AugustoRiedinger/tecDig2_project/doc/proyectoCompleto_Riedinger-Garcia/informe/informe.pdf

# Sistema de adquisión y transmisión de datos autosuficiente y controlable

A. Riedinger
Universidad Tecnológica Nacional Departamento de Electrónica Cátedra de Técnicas Digitales II Bahía Blanca, Argentina
Email: ariedinger4@duck.com
G. Garcia
Universidad Tecnológica Nacional Departamento de Electrónica Cátedra de Técnicas Digitales II Bahía Blanca, Argentina
Email: gerogarcia00@hotmail.com

ÍNDICE

I. | Descripcion general: | 1
II. | Hardware: | 3
II-C. | Descripción del circuito ERDYTC: . . . | 3
II-D. | Descripción del circuito SATDAT: . . . | 3
III. | Software: | 4
I. DESCRIPCION GENERAL:

I-A. Introduccion:
El objetivo del proyecto es construir un sistema digital de sensado autosuficiente, con la premisa de ser controlado a través de una estación de recepción de datos.
Esto es, el proyecto se divide en dos sistemas que trabajan de forma codependiente pero que son controlados por microcontroladores distintos:
Uno es el SATDAC (Sistema de Adquisicón y Transmisión de Datos Autosuficiente y Controlable), encargado de tomar y procesar muestras u obtener datos.
Otro es la ERDYTC (Estación de Recepción de Datos Y Transmisión de Comandos), que se encontraría conectada al SATDAC y se encargaría de mostrar los datos obtenidos.
El SATDAC posee las siguientes capacidades:
Sensado de variables analógicas; actualmente solo temperatura con presición de 2 decimales en un rango de 22.0 °C a 32 °C.
Control y despliegue de periféricos por comando.

Almacenamiento en memoria externa.
Recepción y transmisión de datos por puerto USART. Físicamente, el SATDAC cuenta con una compuerta que está inicialmente cerrada pero puede ser abierta remotamente solo a través de la ERDYTC.
Y la ERDYTC las siguientes:
Capacidad para mostrar datos recibidos y estados en LCD.
Ingreso de comandos por usuario y transmisión de los mismos.
Recepción y transmisión de datos por puerto USART.

I-B. Interfaz con el usuario:
El sistema que más interacciona con el usuario es la ERDYTC. La misma cuenta con las siguientes cualidades: Encendido: el sistema se prende inmediatamente al conetarlo a la red (220 [Vac] @ 50[Hz]).
Pulsadores: el sistema cuenta con cinco (5) pulsadores para que el usuario interaccione con el SATDAC. Estos pulsadores estan denotados en la carcasa del sistema:
- Pulsador 1 - Temperatura: envía un comando al SATDAC para que transmita el valor instantáneo de temperatura tomado. Este valor se visualizará inmediatamente en el display LCD con el que cuenta la ERDYTC.
- Pulsador 2 - Servo posición 1: envía un comando al SATDAC para movilizar el servo a la posición en que destrabará la compuerta de acceso.
- Pulsador 3 - Servo posicipon 2: envía un comando al SATDAC para cerrar a través del mismo servomotor la compuerta de acceso.
- Pulsador 4 - Guardar datos en SD: envía un comando al SATDAC para indicar que guarde el último valor de temperatura leído en la memoria externa SD.
- Pulsador 5 - Reset: pulsador para resetear físicamente la ERDYTC.
Display LCD: el sistema cuenta con un LCD 2x16 donde se muestran los estados y transiciones de la ERDYTC, como también las acciones que realiza en el momento el SATDAC.

Luego, el SATDAC es, como se dijo en la introducción, un sistema cerrado que solo posee una capacidad de interacción con el usuario: la memoria SD donde se almacena el último dato de temperatura medido. Luego, el control del SATDAC se da a través de la ERDYTC.

I-C. Operación:
El sistema está pensado para ser controlado completamente a partir de la ERDYTC. El principio de operación que se debería serguir es el siguiente:
A través de la ERDYTC, presionar el pulsador 1 para indicarle al SATDAC que tome una muestra de temperatura.
Una vez vista la temperatura en el LCD local de la ERDYTC, presionar el pulsador 4 para almacenar dicho valor de temperatura en la SD.
Repetir dicho proceso todas las veces que sea necesario. Una vez finalizado, presionar el pulsador 2 para abrir la ocmpuerta del SATDAC.
Una vez que se indica que la compuerta fue abierta, es posible acceder al SATDAC y realizar la extracción de la memoria SD.
Luego, presionar pulsador 3 para sellar la compuerta; y repetir estos dos últimos pasos una vez que la memoria SD fue utilizada (se extrajeron los datos de la memoria).

I-D. Menúes:
Se describirán los distintos menúes que se visualizan en la ERDYTC.
Pantalla inicial: menú que se muestra al iniciar el sistema. Indica el último valor de temperatura medido por el SATDAC. Se puede visualizar en la Fig. 1.

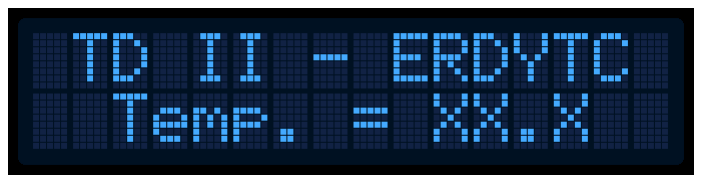
[picture p9: figure]

Figura 1: Menú pantalla inicial

Pantalla actualización temperatura: mensaje que se muestra al presionar el Pulsador 1 - Temperatura. Indica que el SATDAC se encuentra en proceso de actualizar el valor de temperatura. Se puede visualizar en la Fig. 2.

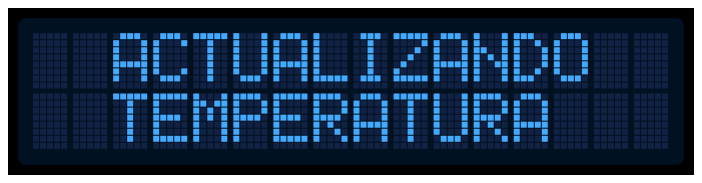
[picture p10: figure]

Figura 2: Pantalla actualización temperatura

. Pantalla servo posición 1: mensaje que se muestra al presionar el Pulsador 2 - Servo posición 1. Indica que el servomotor del SATDAC se movió 90° con respecto a su posición inicial y por tanto se destrabó la compuerta para acceder al mismo. Se puede visualizar en la Fig. 3

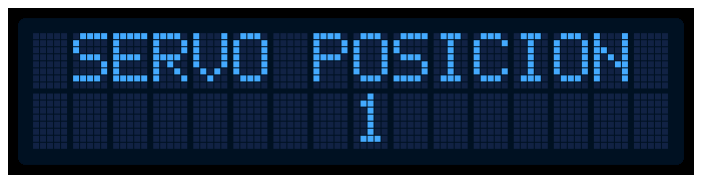
[picture p11: figure]

Figura 3: Pantalla servo posición 1

Pantalla servo posición 2: mensaje que se muestra al presionar el Pulsador 3 - Servo posición 2. Indica que el servomotor del SATDAC se movió 90° con respecto a su posición final y por tanto se trabó la compuerta para acceder al mismo. Se puede visualizar en la Fig. 4.

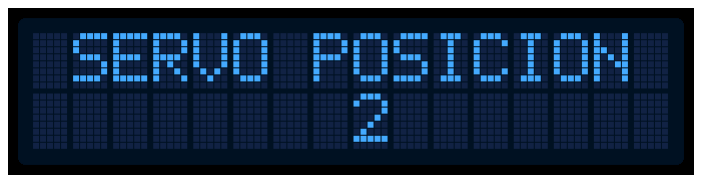
[picture p12: figure]

Figura 4: Pantalla servo posición 2

Pantalla SD: mensaje que se muestra al presionar el Pulsador 4 - SD. Indica que el SATDAC se encuentra en el proceso de guardar el último valor de temperatura en la memoria externa SD. Se puede visualizar en la Fig. 5.

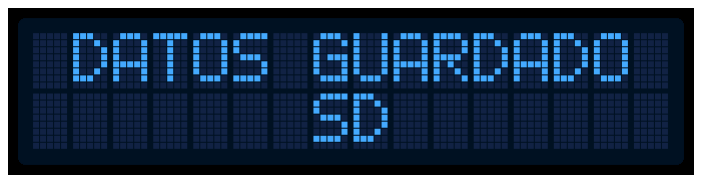
[picture p13: figure]

Figura 5: Pantalla SD

Todos los menúes anteriormente descritos se pueden visualizar durante 5 segundos luego de que aparecen (a exepción de la pantalla inicial, que es el mensaje que se muestra por defecto) para que el usuario tenga tiempo necesario a leer o anotar lo que se ve.

I-E. Mantenimiento:

Para realizar el mantenimiento de la ERDYTC no se debe realizar ninguna operación especial, basta con desarmar la carcasa de la misma y retirar el microcontrolador de la placa PCB que se encuentra en su interior.
En cambio, para realizar el mantenimiento del SATDAC es necesario tener la ERDYTC en funcionamiento. A partir de ello, se debe realizar el siguiente procedimiento:
Presionar el pulsador 2 en la ERDYTC para abrir la compuerta del SATDAC.
Desconectar la ERDYTC de la red de alimentación. Desconetar la batería del SATDAC.

Una vez finalizado el mantenimiento del SATDAC, se debe trabar manualmente la compuerta a partir de colocar el servomotor en su lugar inicial.
I-E1. Seguridad:: Se debe desconectar de la red y/o alimentación todos los elementos antes de realizar el mantenimiento.
Idealmente, también sería inteligente deshacer la conexión entre el SATDAC y la ERDYTC antes de realizar el mantenimiento de un sistema de forma independientemente.

II. HARDWARE:

II-A. Estructuras:
Ambos sistemas se encuentran en estructuras protectoras o carcasas hechas en madera. Las mismas se pueden visualizar en las Fig. 6 y 7 respectivamente.


Figura 6: Carcasa del SATDAC


Figura 7: Carcasa de la ERDYTC

II-B. Diagrama en bloques:
En la Fig. 8 se puede visualizar el diagrama en bloques completo de ambos sistemas interconectados.

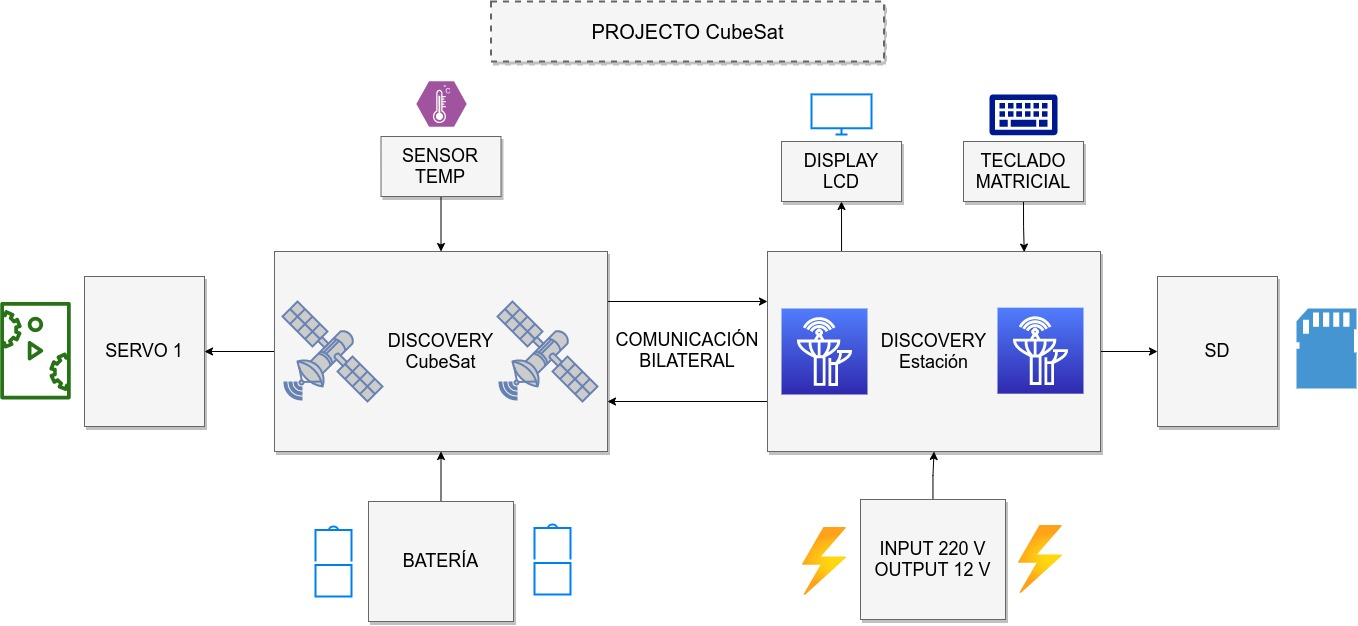
[picture p14: figure]

Figura 8: Diagrama en bloques de los sistemas

En el mismo se puede observar de forma gráfica las distintas conexiones y funciones de los sistemas descritos en este documento. Se observa que el SATDAC posee como alimentación una batería de 3.7 [V], y la ERDYTC se alimenta a partir de la RED. Además, se denotan los diferentes periféricos utilizados en ambos sistemas.

II-C. Descripción del circuito ERDYTC:
En la Fig. 9 se puede observar el circuito esquemático que representa la ERDYTC.


Figura 9: Circuito esquemático de la ERDYTC

En el mismo se describe el conexionado del sistema:
Se utilizaron los conectores CN8 y CN9 de la STM32F429ZI para realizar todas las conexiones a través de un poncho.
La conexión del display LCD se realizó con resistencias de pull-up a 5 voltios, y las conexiones a los pines de la STM se dan todas en el conector CN9.
La conexión de los pulsadores se da en forma matricial. Luego, en la Fig. 10 se puede observar el circuito impreso o PCB de la ERDYTC. En el mismo se nota claramente que se utilizó el conector de Arduino de la STM para realizar el poncho con la placa.
Finalmente, en la Fig. 11 se puede observar el PCB físico de la ERDYTC.

II-D. Descripción del circuito SATDAT:
En la Fig. 12 se puede observar el diagrama esquemático del SATDAC.
En el mismo se puede ver el conexionado del sistema: Se utilizaron los conectores CN8 y CN9 de la STM para realizar el poncho.


Figura 10: ERTDYC PCB

Se utilizó un circuito amplificador de protección para el conexionado del sensor de temperatura LM35.

Los puertos UART usados tanto en el SATDA como ERDYTC fueron el PA2 y PA3 respectivamente, y se corresponden con el UART2 en el sistema.
Luego en la Fig. 13 se puede observar el PCB del SATDAC, y en la Fig. 14 el modelo 3D del mismo.

III. SOFTWARE:

III-A. Código fuente:

La descripción completa de todo el software se puede visualizar en el siguiente enlace: https://github.com/AugustoRiedinger/tecDig2_project/tree/master/code. (https://github.com/AugustoRiedinger/tecDig2_project/tree/master/code)
En el mismo, también se pueden descargar y contribuir a todos los archivos tanto del software como del proyecto en general.
En la carpeta code se puede encontrar y editar el código fuente que se carga en ambos sistemas. Notar que el archivo hardware.h describe los pines utilizados para los dos sistemas; el mismo se puede editar fácilmente y a conveniencia que cambiará todas las funciones donde sea utilizado.

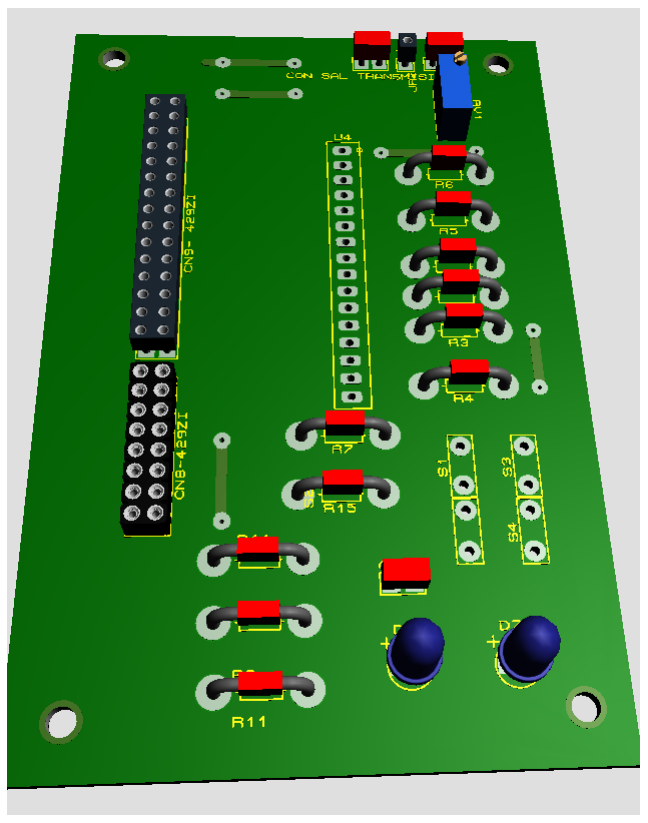
[picture p15: figure]

Figura 11: Render 3D del PCD de la ERDYTC


Figura 12: Esquemático del SATDAC

III-B. Lenguaje:

El lenguaje utilizo en todas las librerías creadas y el código fuente es C, junto con funciones específicas desarrolladas por ST.
C es un lenguaje de programación de propósito general originalmente desarrollado por Dennis Ritchie entre 1969 y 1972 en los Laboratorios Bell, como evolución del anterior lenguaje B, a su vez basado en BCPL.
Al igual que B, es un lenguaje orientado a la implementación de sistemas operativos, concretamente Unix. C es apreciado por la eficiencia del código que produce y es el lenguaje de programación más popular para crear softwares

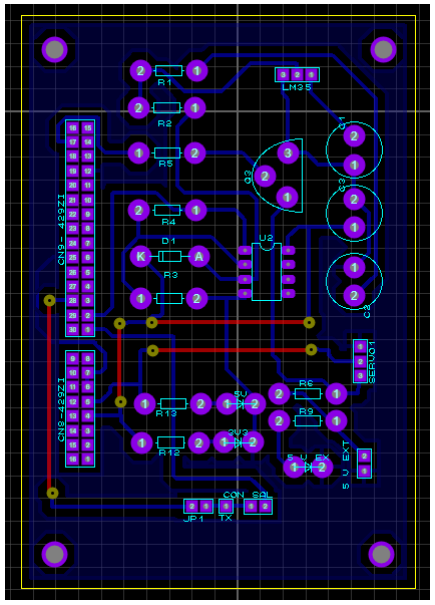
[picture p16: figure]

Figura 13: SATDAC PCB

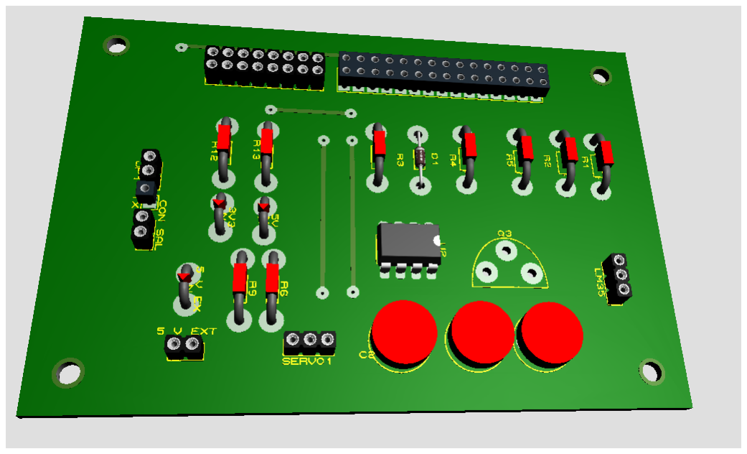
[picture p17: figure]

Figura 14: SATDAC 3D

de sistemas y aplicaciones.
Se trata de un lenguaje de tipos de datos estáticos, débilmente tipado, de medio nivel, que dispone de las estructuras típicas de los lenguajes de alto nivel pero, a su vez, dispone de construcciones del lenguaje que permiten un control a bajo nivel. Los compiladores suelen ofrecer extensiones al lenguaje que posibilitan mezclar código en ensamblador con código C o acceder directamente a memoria o dispositivos periféricos.

III-C. Entorno de desarrollo:

Para editar los archivos principalmente se utilizó el software Doom Emacs; luego para debuggear se utilizó Atollic

TRUEStudio.
Los programas utilizados tanto para editar como para debuggear son a elección, pero los autores solamente testearon en los mencionados.
