AugustoRiedinger/tecDig2_project/doc/proyectoCompleto_Riedinger-Garcia/satdac/PCB SD.png

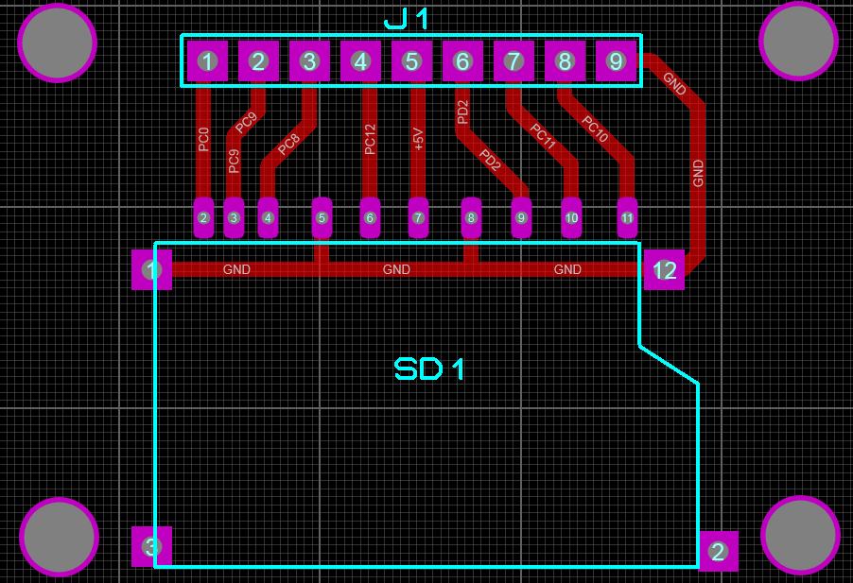
doc/proyectoCompleto_Riedinger-Garcia/satdac/PCB SD.png
