AugustoRiedinger/tecDig2_project/images/estacionEsquematico.BMP

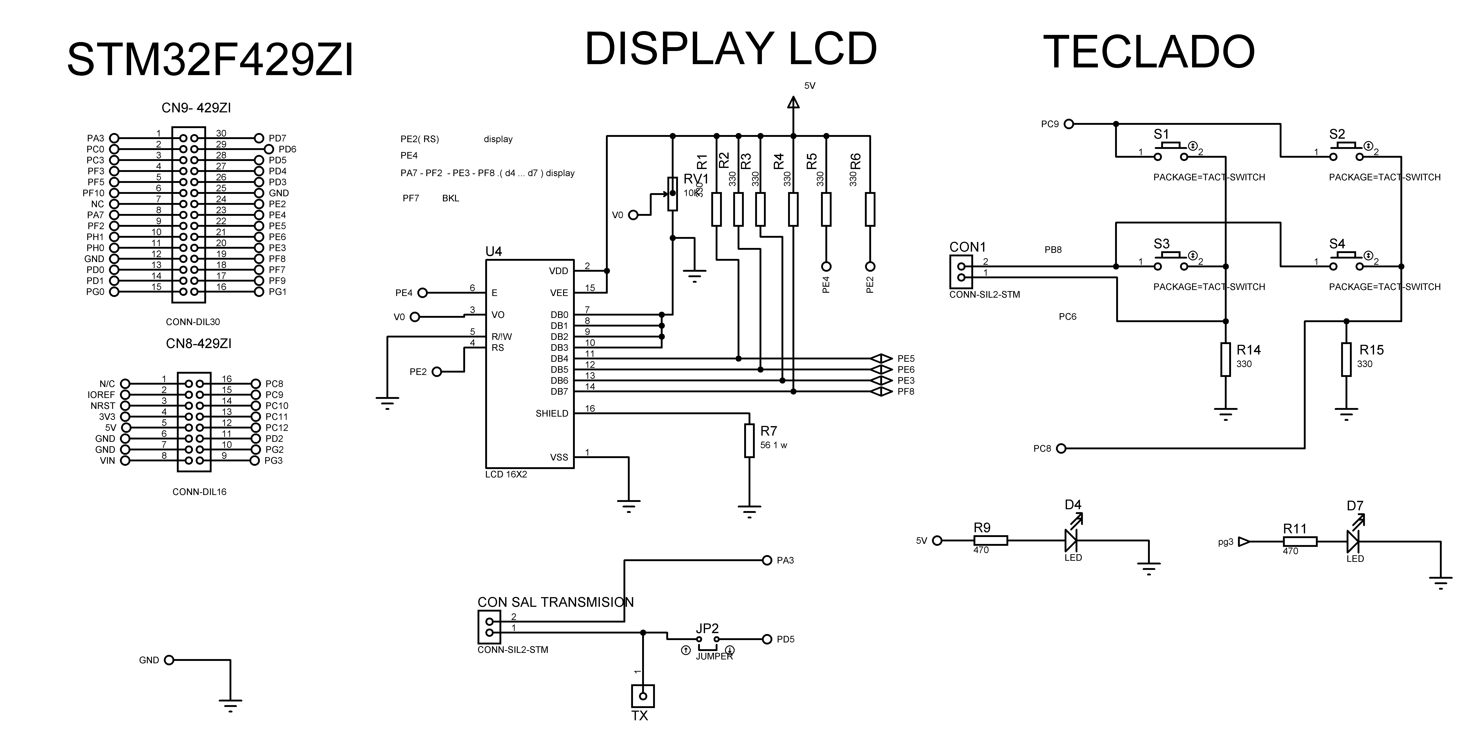
images/estacionEsquematico.BMP
