AugustoRiedinger/tecDig2_project/images/servo_1ms.BMP

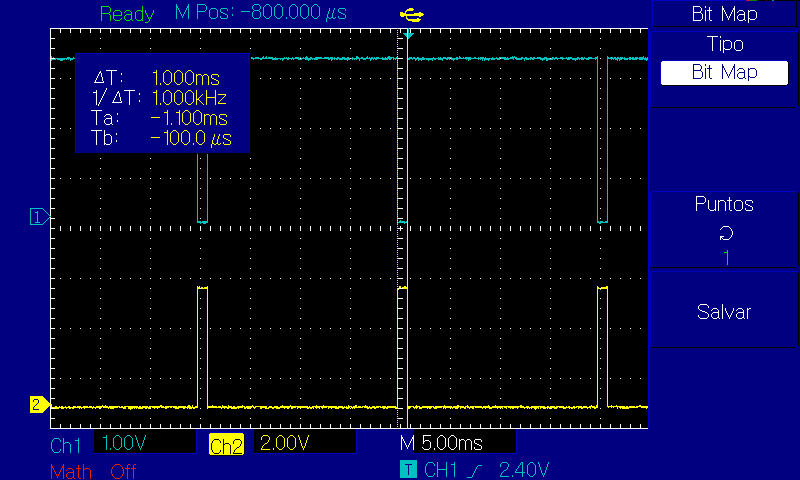
images/servo_1ms.BMP
