AugustoRiedinger/tecDig2_project/(list of files, drawings)

Other design files:
doc/proyectoCompleto_Riedinger-Garcia/proteus/cube V1.4( final).pdsprj
doc/proyectoCompleto_Riedinger-Garcia/proteus/estacion v1.3.pdsprj
