AugustoRiedinger/tecDig2_project/doc/proyectoCompleto_Riedinger-Garcia/satdac/SD-Card 2021-407/src/stm32_ub_sdcard.c

//--------------------------------------------------------------
// File     : stm32_ub_sdcard.c
// Datum    : 01.05.2014
// Version  : 1.2
// Autor    : UB
// EMail    : mc-4u(@)t-online.de
// Web      : www.mikrocontroller-4u.de
// CPU      : STM32F4
// IDE      : CooCox CoIDE 1.7.4
// GCC      : 4.7 2012q4
// Module   : GPIO, MISC, SDIO, DMA
// Funktion : FATFS-Dateisystem für SD-Medien
//            LoLevel-IO-Modul
//            Quelle = STM-Files
//            stm324xg_eval_sdio_sd.c [V1.1.1/11-January-2013]
//            stm324xg_eval.c [V1.1.1/11-January-2013]
// Hinweis  : Betrieb per DMA und SDIO-Schnittstelle
//
// 1bit-Mode :
//
//   PC8  -> SDIO_D0  = SD-Karte DAT0
//   PC12 -> SDIO_CK  = SD-Karte Clock
//   PD2  -> SDIO_CMD = SD-Karte CMD
//
// 4bit-Mode :
//
//   PC8  -> SDIO_D0  = SD-Karte DAT0  (pin 8 tarjeta)
//   PC9  -> SDIO_D1  = SD-Karte DAT1  (pin 9 tarjeta)
//   PC10 -> SDIO_D2  = SD-Karte DAT2  (pin 1 tarjeta)
//   PC11 -> SDIO_D3  = SD-Karte DAT3/CD  (pin 2 tarjeta)
//   PC12 -> SDIO_CK  = SD-Karte Clock  (pin 6 tarjeta)
//   PD2  -> SDIO_CMD = SD-Karte CMD    (pin 3 tarjeta)
//										VDD pin 5
//										GND pin 4 y 7
// mit Detect-Pin :
//
//   PC0  -> SD_Detect-Pin (Hi=ohne SD-Karte)
//            
//              DMA : entweder DMA2_STREAM3_CHANNEL4
//                    oder     DMA2_STREAM6_CHANNEL4
//--------------------------------------------------------------
// Warning  : The STM32F4 in Revision-A generates a
//            "SDIO_IT_DCRCFAIL" in function "SD_ProcessIRQSrc"
//            To avoid this set the Define "SDIO_STM32F4_REV" to 0
//            (check the STM-Errata-Sheet for more information)
//            [Thanks to Major for posting this BUG...UB]
//--------------------------------------------------------------




//--------------------------------------------------------------
// Includes
//--------------------------------------------------------------
#include "stm32_ub_sdcard.h"


//--------------------------------------------------------------
// Globale Variabeln
//--------------------------------------------------------------
static uint32_t CardType =  SDIO_STD_CAPACITY_SD_CARD_V1_1;
static uint32_t CSD_Tab[4], CID_Tab[4], RCA = 0;
static uint8_t SDSTATUS_Tab[16];
__IO uint32_t StopCondition = 0;
__IO SD_Error TransferError = SD_OK;
__IO uint32_t TransferEnd = 0, DMAEndOfTransfer = 0;
SD_CardInfo SDCardInfo;

SDIO_InitTypeDef SDIO_InitStructure;
SDIO_CmdInitTypeDef SDIO_CmdInitStructure;
SDIO_DataInitTypeDef SDIO_DataInitStructure;


//--------------------------------------------------------------
// interne Funktionen
//--------------------------------------------------------------
static void NVIC_Configuration(void);
void SD_DeInit(void);
SD_Error SD_Init(void);
SDTransferState SD_GetStatus(void);
SDCardState SD_GetState(void);
uint8_t SD_Detect(void);
SD_Error SD_PowerON(void);
SD_Error SD_PowerOFF(void);
SD_Error SD_InitializeCards(void);
SD_Error SD_GetCardInfo(SD_CardInfo *cardinfo);
SD_Error SD_GetCardStatus(SD_CardStatus *cardstatus);
SD_Error SD_EnableWideBusOperation(uint32_t WideMode);
SD_Error SD_SelectDeselect(uint64_t addr);
SD_Error SD_ReadBlock(uint8_t *readbuff, uint64_t ReadAddr, uint16_t BlockSize);
SD_Error SD_ReadMultiBlocks(uint8_t *readbuff, uint64_t ReadAddr, uint16_t BlockSize, uint32_t NumberOfBlocks);
SD_Error SD_WaitReadOperation(void);
SD_Error SD_WriteBlock(uint8_t *writebuff, uint64_t WriteAddr, uint16_t BlockSize);
SD_Error SD_WriteMultiBlocks(uint8_t *writebuff, uint64_t WriteAddr, uint16_t BlockSize, uint32_t NumberOfBlocks);
SD_Error SD_WaitWriteOperation(void);
SDTransferState SD_GetTransferState(void);
SD_Error SD_StopTransfer(void);
SD_Error SD_Erase(uint64_t startaddr, uint64_t endaddr);
SD_Error SD_SendStatus(uint32_t *pcardstatus);
SD_Error SD_SendSDStatus(uint32_t *psdstatus);
SD_Error SD_ProcessIRQSrc(void);
void SD_ProcessDMAIRQ(void);
static SD_Error CmdError(void);
static SD_Error CmdResp7Error(void);
static SD_Error CmdResp1Error(uint8_t cmd);
static SD_Error CmdResp3Error(void);
static SD_Error CmdResp2Error(void);
static SD_Error CmdResp6Error(uint8_t cmd, uint16_t *prca);
static SD_Error SDEnWideBus(FunctionalState NewState);
static SD_Error IsCardProgramming(uint8_t *pstatus);
static SD_Error FindSCR(uint16_t rca, uint32_t *pscr);
uint8_t convert_from_bytes_to_power_of_two(uint16_t NumberOfBytes);
SD_Error SD_HighSpeed (void);
//--------------------------------------------------------------
void SD_LowLevel_DeInit(void);
void SD_LowLevel_Init(void);
void SD_LowLevel_DMA_TxConfig(uint32_t *BufferSRC, uint32_t BufferSize);
void SD_LowLevel_DMA_RxConfig(uint32_t *BufferDST, uint32_t BufferSize);
//--------------------------------------------------------------




//--------------------------------------------------------------
// init der Hardware fuer die SDCard-Funktionen
// muss vor der Benutzung einmal gemacht werden
//--------------------------------------------------------------
void UB_SDCard_Init(void)
{
  // Interrupt-Controller initialisieren
  NVIC_Configuration();
  // GPIO initialisieren
  SD_LowLevel_Init();
}


//--------------------------------------------------------------
// Check ob Medium eingelegt ist
// Return Wert :
//   SD_PRESENT      = wenn Medium eingelegt ist
//   SD_NOT_PRESENT  = wenn kein Medium eingelegt ist
//--------------------------------------------------------------
uint8_t UB_SDCard_CheckMedia(void)
{
  __IO uint8_t status = SD_NOT_PRESENT;

  // Abfrage ob SD-Karte eingesteckt
  status=SD_Detect();

  return(status);
}


//--------------------------------------------------------------
// init der Disk
// Return Wert :
//    0 = alles ok
//  < 0 = Fehler
//--------------------------------------------------------------
int MMC_disk_initialize(void)
{
  int ret_wert=-1;
  SD_Error res = SD_OK;
  
  res=SD_Init();
  
  if(res == SD_OK) {
    ret_wert=0; // Ok
  }
  else {
    ret_wert=-1;
  }

  return(ret_wert);
}


//--------------------------------------------------------------
// Disk Status abfragen
// Return Wert :
//    0 = alles ok
//  < 0 = Fehler
//--------------------------------------------------------------
int MMC_disk_status(void)
{
  int ret_wert=-1;
  uint8_t state;

  state=SD_Detect();
  if(state==SD_PRESENT) {
    ret_wert=0;
  }
  else {
    ret_wert=-1;
  }

  return(ret_wert);
}


//--------------------------------------------------------------
// READ-Funktion
// Return Wert :
//    0 = alles ok
//  < 0 = Fehler
//--------------------------------------------------------------
int MMC_disk_read(BYTE *buff, DWORD sector, BYTE count)
{
  int ret_wert=-1;
  SD_Error status = SD_OK;

  SD_ReadMultiBlocks(buff, sector << 9, 512, 1);

  /* Check if the Transfer is finished */
  status =  SD_WaitReadOperation();
  while(SD_GetStatus() != SD_TRANSFER_OK);

  if (status == SD_OK) {
    ret_wert=0;
  }
  else {
    ret_wert=-1;
  }


  return(ret_wert);
}


//--------------------------------------------------------------
// WRITE-Funktion
// Return Wert :
//    0 = alles ok
//  < 0 = Fehler
//--------------------------------------------------------------
int MMC_disk_write(const BYTE *buff, DWORD sector, BYTE count)
{
  int ret_wert=-1;

  SD_Error status = SD_OK;

  SD_WriteMultiBlocks((BYTE *)buff, sector << 9, 512, 1);

  /* Check if the Transfer is finished */
  status = SD_WaitWriteOperation();
  while(SD_GetStatus() != SD_TRANSFER_OK);     

  if (status == SD_OK) {
    ret_wert=0;
  }
  else {
    ret_wert=-1;
  }

  return(ret_wert);
}


//--------------------------------------------------------------
// IOCTL-Funktion
// Return Wert :
//    0 = alles ok
//  < 0 = Fehler
//--------------------------------------------------------------
int MMC_disk_ioctl(BYTE cmd, void *buff)
{
  int ret_wert=0; // immer ok

  switch (cmd) {
    case GET_SECTOR_COUNT :    // Get number of sectors on the disk (DWORD)
      *(DWORD*)buff = 131072;  // 4*1024*32 = 131072
      ret_wert = 0;
    break;
    case GET_SECTOR_SIZE :     // Get R/W sector size (WORD) 
      *(WORD*)buff = 512;
      ret_wert = 0;
    break;
    case GET_BLOCK_SIZE :      // Get erase block size in unit of sector (DWORD)
      *(DWORD*)buff = 32;
      ret_wert = 0;
    break;
    case CTRL_SYNC :
      ret_wert = 0;
    break;
    case CTRL_ERASE_SECTOR :
      ret_wert = 0;
    break;
  }

  return(ret_wert);
}




//--------------------------------------------------------------
static void NVIC_Configuration(void)
{
  NVIC_InitTypeDef NVIC_InitStructure;

  NVIC_PriorityGroupConfig(NVIC_PriorityGroup_1);

  NVIC_InitStructure.NVIC_IRQChannel = SDIO_IRQn;
  NVIC_InitStructure.NVIC_IRQChannelPreemptionPriority = 0;
  NVIC_InitStructure.NVIC_IRQChannelSubPriority = 0;
  NVIC_InitStructure.NVIC_IRQChannelCmd = ENABLE;
  NVIC_Init(&NVIC_InitStructure);
  NVIC_InitStructure.NVIC_IRQChannel = SD_SDIO_DMA_IRQn;
  NVIC_InitStructure.NVIC_IRQChannelPreemptionPriority = 1;
  NVIC_Init(&NVIC_InitStructure);
}



//--------------------------------------------------------------
// Funktionen vom File :
// stm324xg_eval_sdio_sd.c
// V1.1.1
// 11-January-2013
//--------------------------------------------------------------


//--------------------------------------------------------------
void SD_DeInit(void)
{ 
  SD_LowLevel_DeInit();
}

//--------------------------------------------------------------
// Init der SD-Karte
// -> die restliche Initialisierung (GPIO,NVIC)
//    muss schon gemacht sein
//--------------------------------------------------------------
SD_Error SD_Init(void)
{
  __IO SD_Error errorstatus = SD_OK;
  
  
  SDIO_DeInit();

  errorstatus = SD_PowerON();

  if (errorstatus != SD_OK)
  {
    /*!< CMD Response TimeOut (wait for CMDSENT flag) */
    return(errorstatus);
  }

  errorstatus = SD_InitializeCards();

  if (errorstatus != SD_OK)
  {
    /*!< CMD Response TimeOut (wait for CMDSENT flag) */
    return(errorstatus);
  }

  /*!< Configure the SDIO peripheral */
  /*!< SDIO_CK = SDIOCLK / (SDIO_TRANSFER_CLK_DIV + 2) */
  /*!< on STM32F4xx devices, SDIOCLK is fixed to 48MHz */
  SDIO_InitStructure.SDIO_ClockDiv = SDIO_TRANSFER_CLK_DIV;
  SDIO_InitStructure.SDIO_ClockEdge = SDIO_ClockEdge_Rising;
  SDIO_InitStructure.SDIO_ClockBypass = SDIO_ClockBypass_Disable;
  SDIO_InitStructure.SDIO_ClockPowerSave = SDIO_ClockPowerSave_Disable;
  SDIO_InitStructure.SDIO_BusWide = SDIO_BusWide_1b;
  SDIO_InitStructure.SDIO_HardwareFlowControl = SDIO_HardwareFlowControl_Disable;
  SDIO_Init(&SDIO_InitStructure);

  /*----------------- Read CSD/CID MSD registers ------------------*/
  errorstatus = SD_GetCardInfo(&SDCardInfo);

  if (errorstatus == SD_OK)
  {
    /*----------------- Select Card --------------------------------*/
    errorstatus = SD_SelectDeselect((uint32_t) (SDCardInfo.RCA << 16));
  }

  if (errorstatus == SD_OK)
  {
    #if USE_SDIO_4BIT_MODE==1
      errorstatus = SD_EnableWideBusOperation(SDIO_BusWide_4b);
    #else
      errorstatus = SD_EnableWideBusOperation(SDIO_BusWide_1b);
    #endif
  }  

  return(errorstatus);
}

//--------------------------------------------------------------
SDTransferState SD_GetStatus(void)
{
  SDCardState cardstate =  SD_CARD_TRANSFER;

  cardstate = SD_GetState();
  
  if (cardstate == SD_CARD_TRANSFER)
  {
    return(SD_TRANSFER_OK);
  }
  else if(cardstate == SD_CARD_ERROR)
  {
    return (SD_TRANSFER_ERROR);
  }
  else
  {
    return(SD_TRANSFER_BUSY);
  }
}

//--------------------------------------------------------------
SDCardState SD_GetState(void)
{
  uint32_t resp1 = 0;
  
  if(SD_Detect()== SD_PRESENT)
  {
    if (SD_SendStatus(&resp1) != SD_OK)
    {
      return SD_CARD_ERROR;
    }
    else
    {
      return (SDCardState)((resp1 >> 9) & 0x0F);
    }
  }
  else
  {
    return SD_CARD_ERROR;
  }
}

//--------------------------------------------------------------
uint8_t SD_Detect(void)
{
  __IO uint8_t status = SD_PRESENT;

#if USE_DETECT_PIN==1
  /*!< Check GPIO to detect SD */
  if (GPIO_ReadInputDataBit(SD_DETECT_GPIO_PORT, SD_DETECT_PIN) != Bit_RESET)
  {
    status = SD_NOT_PRESENT;
  }
#endif

  return status;
}

//--------------------------------------------------------------
SD_Error SD_PowerON(void)
{
  __IO SD_Error errorstatus = SD_OK;
  uint32_t response = 0, count = 0, validvoltage = 0;
  uint32_t SDType = SD_STD_CAPACITY;

  /*!< Power ON Sequence -----------------------------------------------------*/
  /*!< Configure the SDIO peripheral */
  /*!< SDIO_CK = SDIOCLK / (SDIO_INIT_CLK_DIV + 2) */
  /*!< on STM32F4xx devices, SDIOCLK is fixed to 48MHz */
  /*!< SDIO_CK for initialization should not exceed 400 KHz */  
  SDIO_InitStructure.SDIO_ClockDiv = SDIO_INIT_CLK_DIV;
  SDIO_InitStructure.SDIO_ClockEdge = SDIO_ClockEdge_Rising;
  SDIO_InitStructure.SDIO_ClockBypass = SDIO_ClockBypass_Disable;
  SDIO_InitStructure.SDIO_ClockPowerSave = SDIO_ClockPowerSave_Disable;
  SDIO_InitStructure.SDIO_BusWide = SDIO_BusWide_1b;
  SDIO_InitStructure.SDIO_HardwareFlowControl = SDIO_HardwareFlowControl_Disable;
  SDIO_Init(&SDIO_InitStructure);

  /*!< Set Power State to ON */
  SDIO_SetPowerState(SDIO_PowerState_ON);

  /*!< Enable SDIO Clock */
  SDIO_ClockCmd(ENABLE);

  /*!< CMD0: GO_IDLE_STATE ---------------------------------------------------*/
  /*!< No CMD response required */
  SDIO_CmdInitStructure.SDIO_Argument = 0x0;
  SDIO_CmdInitStructure.SDIO_CmdIndex = SD_CMD_GO_IDLE_STATE;
  SDIO_CmdInitStructure.SDIO_Response = SDIO_Response_No;
  SDIO_CmdInitStructure.SDIO_Wait = SDIO_Wait_No;
  SDIO_CmdInitStructure.SDIO_CPSM = SDIO_CPSM_Enable;
  SDIO_SendCommand(&SDIO_CmdInitStructure);

  errorstatus = CmdError();

  if (errorstatus != SD_OK)
  {
    /*!< CMD Response TimeOut (wait for CMDSENT flag) */
    return(errorstatus);
  }

  /*!< CMD8: SEND_IF_COND ----------------------------------------------------*/
  /*!< Send CMD8 to verify SD card interface operating condition */
  /*!< Argument: - [31:12]: Reserved (shall be set to '0')
               - [11:8]: Supply Voltage (VHS) 0x1 (Range: 2.7-3.6 V)
               - [7:0]: Check Pattern (recommended 0xAA) */
  /*!< CMD Response: R7 */
  SDIO_CmdInitStructure.SDIO_Argument = SD_CHECK_PATTERN;
  SDIO_CmdInitStructure.SDIO_CmdIndex = SDIO_SEND_IF_COND;
  SDIO_CmdInitStructure.SDIO_Response = SDIO_Response_Short;
  SDIO_CmdInitStructure.SDIO_Wait = SDIO_Wait_No;
  SDIO_CmdInitStructure.SDIO_CPSM = SDIO_CPSM_Enable;
  SDIO_SendCommand(&SDIO_CmdInitStructure);

  errorstatus = CmdResp7Error();

  if (errorstatus == SD_OK)
  {
    CardType = SDIO_STD_CAPACITY_SD_CARD_V2_0; /*!< SD Card 2.0 */
    SDType = SD_HIGH_CAPACITY;
  }
  else
  {
    /*!< CMD55 */
    SDIO_CmdInitStructure.SDIO_Argument = 0x00;
    SDIO_CmdInitStructure.SDIO_CmdIndex = SD_CMD_APP_CMD;
    SDIO_CmdInitStructure.SDIO_Response = SDIO_Response_Short;
    SDIO_CmdInitStructure.SDIO_Wait = SDIO_Wait_No;
    SDIO_CmdInitStructure.SDIO_CPSM = SDIO_CPSM_Enable;
    SDIO_SendCommand(&SDIO_CmdInitStructure);
    errorstatus = CmdResp1Error(SD_CMD_APP_CMD);
  }
  /*!< CMD55 */
  SDIO_CmdInitStructure.SDIO_Argument = 0x00;
  SDIO_CmdInitStructure.SDIO_CmdIndex = SD_CMD_APP_CMD;
  SDIO_CmdInitStructure.SDIO_Response = SDIO_Response_Short;
  SDIO_CmdInitStructure.SDIO_Wait = SDIO_Wait_No;
  SDIO_CmdInitStructure.SDIO_CPSM = SDIO_CPSM_Enable;
  SDIO_SendCommand(&SDIO_CmdInitStructure);
  errorstatus = CmdResp1Error(SD_CMD_APP_CMD);

  /*!< If errorstatus is Command TimeOut, it is a MMC card */
  /*!< If errorstatus is SD_OK it is a SD card: SD card 2.0 (voltage range mismatch)
     or SD card 1.x */
  if (errorstatus == SD_OK)
  {
    /*!< SD CARD */
    /*!< Send ACMD41 SD_APP_OP_COND with Argument 0x80100000 */
    while ((!validvoltage) && (count < SD_MAX_VOLT_TRIAL))
    {

      /*!< SEND CMD55 APP_CMD with RCA as 0 */
      SDIO_CmdInitStructure.SDIO_Argument = 0x00;
      SDIO_CmdInitStructure.SDIO_CmdIndex = SD_CMD_APP_CMD;
      SDIO_CmdInitStructure.SDIO_Response = SDIO_Response_Short;
      SDIO_CmdInitStructure.SDIO_Wait = SDIO_Wait_No;
      SDIO_CmdInitStructure.SDIO_CPSM = SDIO_CPSM_Enable;
      SDIO_SendCommand(&SDIO_CmdInitStructure);

      errorstatus = CmdResp1Error(SD_CMD_APP_CMD);

      if (errorstatus != SD_OK)
      {
        return(errorstatus);
      }
      SDIO_CmdInitStructure.SDIO_Argument = SD_VOLTAGE_WINDOW_SD | SDType;
      SDIO_CmdInitStructure.SDIO_CmdIndex = SD_CMD_SD_APP_OP_COND;
      SDIO_CmdInitStructure.SDIO_Response = SDIO_Response_Short;
      SDIO_CmdInitStructure.SDIO_Wait = SDIO_Wait_No;
      SDIO_CmdInitStructure.SDIO_CPSM = SDIO_CPSM_Enable;
      SDIO_SendCommand(&SDIO_CmdInitStructure);

      errorstatus = CmdResp3Error();
      if (errorstatus != SD_OK)
      {
        return(errorstatus);
      }

      response = SDIO_GetResponse(SDIO_RESP1);
      validvoltage = (((response >> 31) == 1) ? 1 : 0);
      count++;
    }
    if (count >= SD_MAX_VOLT_TRIAL)
    {
      errorstatus = SD_INVALID_VOLTRANGE;
      return(errorstatus);
    }

    if (response &= SD_HIGH_CAPACITY)
    {
      CardType = SDIO_HIGH_CAPACITY_SD_CARD;
    }

  }/*!< else MMC Card */

  return(errorstatus);
}

//--------------------------------------------------------------
SD_Error SD_PowerOFF(void)
{
  SD_Error errorstatus = SD_OK;

  /*!< Set Power State to OFF */
  SDIO_SetPowerState(SDIO_PowerState_OFF);

  return(errorstatus);
}

//--------------------------------------------------------------
SD_Error SD_InitializeCards(void)
{
  SD_Error errorstatus = SD_OK;
  uint16_t rca = 0x01;

  if (SDIO_GetPowerState() == SDIO_PowerState_OFF)
  {
    errorstatus = SD_REQUEST_NOT_APPLICABLE;
    return(errorstatus);
  }

  if (SDIO_SECURE_DIGITAL_IO_CARD != CardType)
  {
    /*!< Send CMD2 ALL_SEND_CID */
    SDIO_CmdInitStructure.SDIO_Argument = 0x0;
    SDIO_CmdInitStructure.SDIO_CmdIndex = SD_CMD_ALL_SEND_CID;
    SDIO_CmdInitStructure.SDIO_Response = SDIO_Response_Long;
    SDIO_CmdInitStructure.SDIO_Wait = SDIO_Wait_No;
    SDIO_CmdInitStructure.SDIO_CPSM = SDIO_CPSM_Enable;
    SDIO_SendCommand(&SDIO_CmdInitStructure);

    errorstatus = CmdResp2Error();

    if (SD_OK != errorstatus)
    {
      return(errorstatus);
    }

    CID_Tab[0] = SDIO_GetResponse(SDIO_RESP1);
    CID_Tab[1] = SDIO_GetResponse(SDIO_RESP2);
    CID_Tab[2] = SDIO_GetResponse(SDIO_RESP3);
    CID_Tab[3] = SDIO_GetResponse(SDIO_RESP4);
  }
  if ((SDIO_STD_CAPACITY_SD_CARD_V1_1 == CardType) ||  (SDIO_STD_CAPACITY_SD_CARD_V2_0 == CardType) ||  (SDIO_SECURE_DIGITAL_IO_COMBO_CARD == CardType)
      ||  (SDIO_HIGH_CAPACITY_SD_CARD == CardType))
  {
    /*!< Send CMD3 SET_REL_ADDR with argument 0 */
    /*!< SD Card publishes its RCA. */
    SDIO_CmdInitStructure.SDIO_Argument = 0x00;
    SDIO_CmdInitStructure.SDIO_CmdIndex = SD_CMD_SET_REL_ADDR;
    SDIO_CmdInitStructure.SDIO_Response = SDIO_Response_Short;
    SDIO_CmdInitStructure.SDIO_Wait = SDIO_Wait_No;
    SDIO_CmdInitStructure.SDIO_CPSM = SDIO_CPSM_Enable;
    SDIO_SendCommand(&SDIO_CmdInitStructure);

    errorstatus = CmdResp6Error(SD_CMD_SET_REL_ADDR, &rca);

    if (SD_OK != errorstatus)
    {
      return(errorstatus);
    }
  }

  if (SDIO_SECURE_DIGITAL_IO_CARD != CardType)
  {
    RCA = rca;

    /*!< Send CMD9 SEND_CSD with argument as card's RCA */
    SDIO_CmdInitStructure.SDIO_Argument = (uint32_t)(rca << 16);
    SDIO_CmdInitStructure.SDIO_CmdIndex = SD_CMD_SEND_CSD;
    SDIO_CmdInitStructure.SDIO_Response = SDIO_Response_Long;
    SDIO_CmdInitStructure.SDIO_Wait = SDIO_Wait_No;
    SDIO_CmdInitStructure.SDIO_CPSM = SDIO_CPSM_Enable;
    SDIO_SendCommand(&SDIO_CmdInitStructure);

    errorstatus = CmdResp2Error();

    if (SD_OK != errorstatus)
    {
      return(errorstatus);
    }

    CSD_Tab[0] = SDIO_GetResponse(SDIO_RESP1);
    CSD_Tab[1] = SDIO_GetResponse(SDIO_RESP2);
    CSD_Tab[2] = SDIO_GetResponse(SDIO_RESP3);
    CSD_Tab[3] = SDIO_GetResponse(SDIO_RESP4);
  }

  errorstatus = SD_OK; /*!< All cards get intialized */

  return(errorstatus);
}

//--------------------------------------------------------------
SD_Error SD_GetCardInfo(SD_CardInfo *cardinfo)
{
  SD_Error errorstatus = SD_OK;
  uint8_t tmp = 0;

  cardinfo->CardType = (uint8_t)CardType;
  cardinfo->RCA = (uint16_t)RCA;

  /*!< Byte 0 */
  tmp = (uint8_t)((CSD_Tab[0] & 0xFF000000) >> 24);
  cardinfo->SD_csd.CSDStruct = (tmp & 0xC0) >> 6;
  cardinfo->SD_csd.SysSpecVersion = (tmp & 0x3C) >> 2;
  cardinfo->SD_csd.Reserved1 = tmp & 0x03;

  /*!< Byte 1 */
  tmp = (uint8_t)((CSD_Tab[0] & 0x00FF0000) >> 16);
  cardinfo->SD_csd.TAAC = tmp;

  /*!< Byte 2 */
  tmp = (uint8_t)((CSD_Tab[0] & 0x0000FF00) >> 8);
  cardinfo->SD_csd.NSAC = tmp;

  /*!< Byte 3 */
  tmp = (uint8_t)(CSD_Tab[0] & 0x000000FF);
  cardinfo->SD_csd.MaxBusClkFrec = tmp;

  /*!< Byte 4 */
  tmp = (uint8_t)((CSD_Tab[1] & 0xFF000000) >> 24);
  cardinfo->SD_csd.CardComdClasses = tmp << 4;

  /*!< Byte 5 */
  tmp = (uint8_t)((CSD_Tab[1] & 0x00FF0000) >> 16);
  cardinfo->SD_csd.CardComdClasses |= (tmp & 0xF0) >> 4;
  cardinfo->SD_csd.RdBlockLen = tmp & 0x0F;

  /*!< Byte 6 */
  tmp = (uint8_t)((CSD_Tab[1] & 0x0000FF00) >> 8);
  cardinfo->SD_csd.PartBlockRead = (tmp & 0x80) >> 7;
  cardinfo->SD_csd.WrBlockMisalign = (tmp & 0x40) >> 6;
  cardinfo->SD_csd.RdBlockMisalign = (tmp & 0x20) >> 5;
  cardinfo->SD_csd.DSRImpl = (tmp & 0x10) >> 4;
  cardinfo->SD_csd.Reserved2 = 0; /*!< Reserved */

  if ((CardType == SDIO_STD_CAPACITY_SD_CARD_V1_1) || (CardType == SDIO_STD_CAPACITY_SD_CARD_V2_0))
  {
    cardinfo->SD_csd.DeviceSize = (tmp & 0x03) << 10;

    /*!< Byte 7 */
    tmp = (uint8_t)(CSD_Tab[1] & 0x000000FF);
    cardinfo->SD_csd.DeviceSize |= (tmp) << 2;

    /*!< Byte 8 */
    tmp = (uint8_t)((CSD_Tab[2] & 0xFF000000) >> 24);
    cardinfo->SD_csd.DeviceSize |= (tmp & 0xC0) >> 6;

    cardinfo->SD_csd.MaxRdCurrentVDDMin = (tmp & 0x38) >> 3;
    cardinfo->SD_csd.MaxRdCurrentVDDMax = (tmp & 0x07);

    /*!< Byte 9 */
    tmp = (uint8_t)((CSD_Tab[2] & 0x00FF0000) >> 16);
    cardinfo->SD_csd.MaxWrCurrentVDDMin = (tmp & 0xE0) >> 5;
    cardinfo->SD_csd.MaxWrCurrentVDDMax = (tmp & 0x1C) >> 2;
    cardinfo->SD_csd.DeviceSizeMul = (tmp & 0x03) << 1;
    /*!< Byte 10 */
    tmp = (uint8_t)((CSD_Tab[2] & 0x0000FF00) >> 8);
    cardinfo->SD_csd.DeviceSizeMul |= (tmp & 0x80) >> 7;
    
    cardinfo->CardCapacity = (cardinfo->SD_csd.DeviceSize + 1) ;
    cardinfo->CardCapacity *= (1 << (cardinfo->SD_csd.DeviceSizeMul + 2));
    cardinfo->CardBlockSize = 1 << (cardinfo->SD_csd.RdBlockLen);
    cardinfo->CardCapacity *= cardinfo->CardBlockSize;
  }
  else if (CardType == SDIO_HIGH_CAPACITY_SD_CARD)
  {
    /*!< Byte 7 */
    tmp = (uint8_t)(CSD_Tab[1] & 0x000000FF);
    cardinfo->SD_csd.DeviceSize = (tmp & 0x3F) << 16;

    /*!< Byte 8 */
    tmp = (uint8_t)((CSD_Tab[2] & 0xFF000000) >> 24);

    cardinfo->SD_csd.DeviceSize |= (tmp << 8);

    /*!< Byte 9 */
    tmp = (uint8_t)((CSD_Tab[2] & 0x00FF0000) >> 16);

    cardinfo->SD_csd.DeviceSize |= (tmp);

    /*!< Byte 10 */
    tmp = (uint8_t)((CSD_Tab[2] & 0x0000FF00) >> 8);
    
    cardinfo->CardCapacity = ((uint64_t)cardinfo->SD_csd.DeviceSize + 1) * 512 * 1024;
    cardinfo->CardBlockSize = 512;    
  }


  cardinfo->SD_csd.EraseGrSize = (tmp & 0x40) >> 6;
  cardinfo->SD_csd.EraseGrMul = (tmp & 0x3F) << 1;

  /*!< Byte 11 */
  tmp = (uint8_t)(CSD_Tab[2] & 0x000000FF);
  cardinfo->SD_csd.EraseGrMul |= (tmp & 0x80) >> 7;
  cardinfo->SD_csd.WrProtectGrSize = (tmp & 0x7F);

  /*!< Byte 12 */
  tmp = (uint8_t)((CSD_Tab[3] & 0xFF000000) >> 24);
  cardinfo->SD_csd.WrProtectGrEnable = (tmp & 0x80) >> 7;
  cardinfo->SD_csd.ManDeflECC = (tmp & 0x60) >> 5;
  cardinfo->SD_csd.WrSpeedFact = (tmp & 0x1C) >> 2;
  cardinfo->SD_csd.MaxWrBlockLen = (tmp & 0x03) << 2;

  /*!< Byte 13 */
  tmp = (uint8_t)((CSD_Tab[3] & 0x00FF0000) >> 16);
  cardinfo->SD_csd.MaxWrBlockLen |= (tmp & 0xC0) >> 6;
  cardinfo->SD_csd.WriteBlockPaPartial = (tmp & 0x20) >> 5;
  cardinfo->SD_csd.Reserved3 = 0;
  cardinfo->SD_csd.ContentProtectAppli = (tmp & 0x01);

  /*!< Byte 14 */
  tmp = (uint8_t)((CSD_Tab[3] & 0x0000FF00) >> 8);
  cardinfo->SD_csd.FileFormatGrouop = (tmp & 0x80) >> 7;
  cardinfo->SD_csd.CopyFlag = (tmp & 0x40) >> 6;
  cardinfo->SD_csd.PermWrProtect = (tmp & 0x20) >> 5;
  cardinfo->SD_csd.TempWrProtect = (tmp & 0x10) >> 4;
  cardinfo->SD_csd.FileFormat = (tmp & 0x0C) >> 2;
  cardinfo->SD_csd.ECC = (tmp & 0x03);

  /*!< Byte 15 */
  tmp = (uint8_t)(CSD_Tab[3] & 0x000000FF);
  cardinfo->SD_csd.CSD_CRC = (tmp & 0xFE) >> 1;
  cardinfo->SD_csd.Reserved4 = 1;


  /*!< Byte 0 */
  tmp = (uint8_t)((CID_Tab[0] & 0xFF000000) >> 24);
  cardinfo->SD_cid.ManufacturerID = tmp;

  /*!< Byte 1 */
  tmp = (uint8_t)((CID_Tab[0] & 0x00FF0000) >> 16);
  cardinfo->SD_cid.OEM_AppliID = tmp << 8;

  /*!< Byte 2 */
  tmp = (uint8_t)((CID_Tab[0] & 0x000000FF00) >> 8);
  cardinfo->SD_cid.OEM_AppliID |= tmp;

  /*!< Byte 3 */
  tmp = (uint8_t)(CID_Tab[0] & 0x000000FF);
  cardinfo->SD_cid.ProdName1 = tmp << 24;

  /*!< Byte 4 */
  tmp = (uint8_t)((CID_Tab[1] & 0xFF000000) >> 24);
  cardinfo->SD_cid.ProdName1 |= tmp << 16;

  /*!< Byte 5 */
  tmp = (uint8_t)((CID_Tab[1] & 0x00FF0000) >> 16);
  cardinfo->SD_cid.ProdName1 |= tmp << 8;

  /*!< Byte 6 */
  tmp = (uint8_t)((CID_Tab[1] & 0x0000FF00) >> 8);
  cardinfo->SD_cid.ProdName1 |= tmp;

  /*!< Byte 7 */
  tmp = (uint8_t)(CID_Tab[1] & 0x000000FF);
  cardinfo->SD_cid.ProdName2 = tmp;

  /*!< Byte 8 */
  tmp = (uint8_t)((CID_Tab[2] & 0xFF000000) >> 24);
  cardinfo->SD_cid.ProdRev = tmp;

  /*!< Byte 9 */
  tmp = (uint8_t)((CID_Tab[2] & 0x00FF0000) >> 16);
  cardinfo->SD_cid.ProdSN = tmp << 24;

  /*!< Byte 10 */
  tmp = (uint8_t)((CID_Tab[2] & 0x0000FF00) >> 8);
  cardinfo->SD_cid.ProdSN |= tmp << 16;

  /*!< Byte 11 */
  tmp = (uint8_t)(CID_Tab[2] & 0x000000FF);
  cardinfo->SD_cid.ProdSN |= tmp << 8;

  /*!< Byte 12 */
  tmp = (uint8_t)((CID_Tab[3] & 0xFF000000) >> 24);
  cardinfo->SD_cid.ProdSN |= tmp;

  /*!< Byte 13 */
  tmp = (uint8_t)((CID_Tab[3] & 0x00FF0000) >> 16);
  cardinfo->SD_cid.Reserved1 |= (tmp & 0xF0) >> 4;
  cardinfo->SD_cid.ManufactDate = (tmp & 0x0F) << 8;

  /*!< Byte 14 */
  tmp = (uint8_t)((CID_Tab[3] & 0x0000FF00) >> 8);
  cardinfo->SD_cid.ManufactDate |= tmp;

  /*!< Byte 15 */
  tmp = (uint8_t)(CID_Tab[3] & 0x000000FF);
  cardinfo->SD_cid.CID_CRC = (tmp & 0xFE) >> 1;
  cardinfo->SD_cid.Reserved2 = 1;
  
  return(errorstatus);
}

//--------------------------------------------------------------
SD_Error SD_GetCardStatus(SD_CardStatus *cardstatus)
{
  SD_Error errorstatus = SD_OK;
  uint8_t tmp = 0;

  errorstatus = SD_SendSDStatus((uint32_t *)SDSTATUS_Tab);

  if (errorstatus  != SD_OK)
  {
    return(errorstatus);
  }

  /*!< Byte 0 */
  tmp = (uint8_t)((SDSTATUS_Tab[0] & 0xC0) >> 6);
  cardstatus->DAT_BUS_WIDTH = tmp;

  /*!< Byte 0 */
  tmp = (uint8_t)((SDSTATUS_Tab[0] & 0x20) >> 5);
  cardstatus->SECURED_MODE = tmp;

  /*!< Byte 2 */
  tmp = (uint8_t)((SDSTATUS_Tab[2] & 0xFF));
  cardstatus->SD_CARD_TYPE = tmp << 8;

  /*!< Byte 3 */
  tmp = (uint8_t)((SDSTATUS_Tab[3] & 0xFF));
  cardstatus->SD_CARD_TYPE |= tmp;

  /*!< Byte 4 */
  tmp = (uint8_t)(SDSTATUS_Tab[4] & 0xFF);
  cardstatus->SIZE_OF_PROTECTED_AREA = tmp << 24;

  /*!< Byte 5 */
  tmp = (uint8_t)(SDSTATUS_Tab[5] & 0xFF);
  cardstatus->SIZE_OF_PROTECTED_AREA |= tmp << 16;

  /*!< Byte 6 */
  tmp = (uint8_t)(SDSTATUS_Tab[6] & 0xFF);
  cardstatus->SIZE_OF_PROTECTED_AREA |= tmp << 8;

  /*!< Byte 7 */
  tmp = (uint8_t)(SDSTATUS_Tab[7] & 0xFF);
  cardstatus->SIZE_OF_PROTECTED_AREA |= tmp;

  /*!< Byte 8 */
  tmp = (uint8_t)((SDSTATUS_Tab[8] & 0xFF));
  cardstatus->SPEED_CLASS = tmp;

  /*!< Byte 9 */
  tmp = (uint8_t)((SDSTATUS_Tab[9] & 0xFF));
  cardstatus->PERFORMANCE_MOVE = tmp;

  /*!< Byte 10 */
  tmp = (uint8_t)((SDSTATUS_Tab[10] & 0xF0) >> 4);
  cardstatus->AU_SIZE = tmp;

  /*!< Byte 11 */
  tmp = (uint8_t)(SDSTATUS_Tab[11] & 0xFF);
  cardstatus->ERASE_SIZE = tmp << 8;

  /*!< Byte 12 */
  tmp = (uint8_t)(SDSTATUS_Tab[12] & 0xFF);
  cardstatus->ERASE_SIZE |= tmp;

  /*!< Byte 13 */
  tmp = (uint8_t)((SDSTATUS_Tab[13] & 0xFC) >> 2);
  cardstatus->ERASE_TIMEOUT = tmp;

  /*!< Byte 13 */
  tmp = (uint8_t)((SDSTATUS_Tab[13] & 0x3));
  cardstatus->ERASE_OFFSET = tmp;
 
  return(errorstatus);
}

//--------------------------------------------------------------
SD_Error SD_EnableWideBusOperation(uint32_t WideMode)
{
  SD_Error errorstatus = SD_OK;

  /*!< MMC Card doesn't support this feature */
  if (SDIO_MULTIMEDIA_CARD == CardType)
  {
    errorstatus = SD_UNSUPPORTED_FEATURE;
    return(errorstatus);
  }
  else if ((SDIO_STD_CAPACITY_SD_CARD_V1_1 == CardType) || (SDIO_STD_CAPACITY_SD_CARD_V2_0 == CardType) || (SDIO_HIGH_CAPACITY_SD_CARD == CardType))
  {
    if (SDIO_BusWide_8b == WideMode)
    {
      errorstatus = SD_UNSUPPORTED_FEATURE;
      return(errorstatus);
    }
    else if (SDIO_BusWide_4b == WideMode)
    {
      errorstatus = SDEnWideBus(ENABLE);

      if (SD_OK == errorstatus)
      {
        /*!< Configure the SDIO peripheral */
        SDIO_InitStructure.SDIO_ClockDiv = SDIO_TRANSFER_CLK_DIV; 
        SDIO_InitStructure.SDIO_ClockEdge = SDIO_ClockEdge_Rising;
        SDIO_InitStructure.SDIO_ClockBypass = SDIO_ClockBypass_Disable;
        SDIO_InitStructure.SDIO_ClockPowerSave = SDIO_ClockPowerSave_Disable;
        SDIO_InitStructure.SDIO_BusWide = SDIO_BusWide_4b;
        SDIO_InitStructure.SDIO_HardwareFlowControl = SDIO_HardwareFlowControl_Disable;
        SDIO_Init(&SDIO_InitStructure);
      }
    }
    else
    {
      errorstatus = SDEnWideBus(DISABLE);

      if (SD_OK == errorstatus)
      {
        /*!< Configure the SDIO peripheral */
        SDIO_InitStructure.SDIO_ClockDiv = SDIO_TRANSFER_CLK_DIV; 
        SDIO_InitStructure.SDIO_ClockEdge = SDIO_ClockEdge_Rising;
        SDIO_InitStructure.SDIO_ClockBypass = SDIO_ClockBypass_Disable;
        SDIO_InitStructure.SDIO_ClockPowerSave = SDIO_ClockPowerSave_Disable;
        SDIO_InitStructure.SDIO_BusWide = SDIO_BusWide_1b;
        SDIO_InitStructure.SDIO_HardwareFlowControl = SDIO_HardwareFlowControl_Disable;
        SDIO_Init(&SDIO_InitStructure);
      }
    }
  }

  return(errorstatus);
}

//--------------------------------------------------------------
SD_Error SD_SelectDeselect(uint64_t addr)
{
  SD_Error errorstatus = SD_OK;

  /*!< Send CMD7 SDIO_SEL_DESEL_CARD */
  SDIO_CmdInitStructure.SDIO_Argument =  (uint32_t)addr;
  SDIO_CmdInitStructure.SDIO_CmdIndex = SD_CMD_SEL_DESEL_CARD;
  SDIO_CmdInitStructure.SDIO_Response = SDIO_Response_Short;
  SDIO_CmdInitStructure.SDIO_Wait = SDIO_Wait_No;
  SDIO_CmdInitStructure.SDIO_CPSM = SDIO_CPSM_Enable;
  SDIO_SendCommand(&SDIO_CmdInitStructure);

  errorstatus = CmdResp1Error(SD_CMD_SEL_DESEL_CARD);

  return(errorstatus);
}

//--------------------------------------------------------------
SD_Error SD_ReadBlock(uint8_t *readbuff, uint64_t ReadAddr, uint16_t BlockSize)
{
  SD_Error errorstatus = SD_OK;
#if defined (SD_POLLING_MODE) 
  uint32_t count = 0, *tempbuff = (uint32_t *)readbuff;
#endif

  TransferError = SD_OK;
  TransferEnd = 0;
  StopCondition = 0;

  SDIO->DCTRL = 0x0;

#if defined (SD_DMA_MODE)
  SDIO_ITConfig(SDIO_IT_DCRCFAIL | SDIO_IT_DTIMEOUT | SDIO_IT_DATAEND | SDIO_IT_RXOVERR | SDIO_IT_STBITERR, ENABLE);
  SDIO_DMACmd(ENABLE);
  SD_LowLevel_DMA_RxConfig((uint32_t *)readbuff, BlockSize);
#endif

  if (CardType == SDIO_HIGH_CAPACITY_SD_CARD)
  {
    BlockSize = 512;
    ReadAddr /= 512;
  }

  /* Set Block Size for Card */ 
  SDIO_CmdInitStructure.SDIO_Argument = (uint32_t) BlockSize;
  SDIO_CmdInitStructure.SDIO_CmdIndex = SD_CMD_SET_BLOCKLEN;
  SDIO_CmdInitStructure.SDIO_Response = SDIO_Response_Short;
  SDIO_CmdInitStructure.SDIO_Wait = SDIO_Wait_No;
  SDIO_CmdInitStructure.SDIO_CPSM = SDIO_CPSM_Enable;
  SDIO_SendCommand(&SDIO_CmdInitStructure);

  errorstatus = CmdResp1Error(SD_CMD_SET_BLOCKLEN);

  if (SD_OK != errorstatus)
  {
    return(errorstatus);
  }

  SDIO_DataInitStructure.SDIO_DataTimeOut = SD_DATATIMEOUT;
  SDIO_DataInitStructure.SDIO_DataLength = BlockSize;
  SDIO_DataInitStructure.SDIO_DataBlockSize = (uint32_t) 9 << 4;
  SDIO_DataInitStructure.SDIO_TransferDir = SDIO_TransferDir_ToSDIO;
  SDIO_DataInitStructure.SDIO_TransferMode = SDIO_TransferMode_Block;
  SDIO_DataInitStructure.SDIO_DPSM = SDIO_DPSM_Enable;
  SDIO_DataConfig(&SDIO_DataInitStructure);

  /*!< Send CMD17 READ_SINGLE_BLOCK */
  SDIO_CmdInitStructure.SDIO_Argument = (uint32_t)ReadAddr;
  SDIO_CmdInitStructure.SDIO_CmdIndex = SD_CMD_READ_SINGLE_BLOCK;
  SDIO_CmdInitStructure.SDIO_Response = SDIO_Response_Short;
  SDIO_CmdInitStructure.SDIO_Wait = SDIO_Wait_No;
  SDIO_CmdInitStructure.SDIO_CPSM = SDIO_CPSM_Enable;
  SDIO_SendCommand(&SDIO_CmdInitStructure);

  errorstatus = CmdResp1Error(SD_CMD_READ_SINGLE_BLOCK);

  if (errorstatus != SD_OK)
  {
    return(errorstatus);
  }

#if defined (SD_POLLING_MODE)  
  /*!< In case of single block transfer, no need of stop transfer at all.*/
  /*!< Polling mode */
  while (!(SDIO->STA &(SDIO_FLAG_RXOVERR | SDIO_FLAG_DCRCFAIL | SDIO_FLAG_DTIMEOUT | SDIO_FLAG_DBCKEND | SDIO_FLAG_STBITERR)))
  {
    if (SDIO_GetFlagStatus(SDIO_FLAG_RXFIFOHF) != RESET)
    {
      for (count = 0; count < 8; count++)
      {
        *(tempbuff + count) = SDIO_ReadData();
      }
      tempbuff += 8;
    }
  }

  if (SDIO_GetFlagStatus(SDIO_FLAG_DTIMEOUT) != RESET)
  {
    SDIO_ClearFlag(SDIO_FLAG_DTIMEOUT);
    errorstatus = SD_DATA_TIMEOUT;
    return(errorstatus);
  }
  else if (SDIO_GetFlagStatus(SDIO_FLAG_DCRCFAIL) != RESET)
  {
    SDIO_ClearFlag(SDIO_FLAG_DCRCFAIL);
    errorstatus = SD_DATA_CRC_FAIL;
    return(errorstatus);
  }
  else if (SDIO_GetFlagStatus(SDIO_FLAG_RXOVERR) != RESET)
  {
    SDIO_ClearFlag(SDIO_FLAG_RXOVERR);
    errorstatus = SD_RX_OVERRUN;
    return(errorstatus);
  }
  else if (SDIO_GetFlagStatus(SDIO_FLAG_STBITERR) != RESET)
  {
    SDIO_ClearFlag(SDIO_FLAG_STBITERR);
    errorstatus = SD_START_BIT_ERR;
    return(errorstatus);
  }
  count = SD_DATATIMEOUT;
  while ((SDIO_GetFlagStatus(SDIO_FLAG_RXDAVL) != RESET) && (count > 0))
  {
    *tempbuff = SDIO_ReadData();
    tempbuff++;
    count--;
  }

  /*!< Clear all the static flags */
  SDIO_ClearFlag(SDIO_STATIC_FLAGS);

#endif

  return(errorstatus);
}

//--------------------------------------------------------------
SD_Error SD_ReadMultiBlocks(uint8_t *readbuff, uint64_t ReadAddr, uint16_t BlockSize, uint32_t NumberOfBlocks)
{
  SD_Error errorstatus = SD_OK;
  TransferError = SD_OK;
  TransferEnd = 0;
  StopCondition = 1;
	
  SDIO->DCTRL = 0x0;

  SDIO_ITConfig(SDIO_IT_DCRCFAIL | SDIO_IT_DTIMEOUT | SDIO_IT_DATAEND | SDIO_IT_RXOVERR | SDIO_IT_STBITERR, ENABLE);
  SD_LowLevel_DMA_RxConfig((uint32_t *)readbuff, (NumberOfBlocks * BlockSize));
  SDIO_DMACmd(ENABLE);

  if (CardType == SDIO_HIGH_CAPACITY_SD_CARD)
  {
    BlockSize = 512;
    ReadAddr /= 512;
  }

  /*!< Set Block Size for Card */
  SDIO_CmdInitStructure.SDIO_Argument = (uint32_t) BlockSize;
  SDIO_CmdInitStructure.SDIO_CmdIndex = SD_CMD_SET_BLOCKLEN;
  SDIO_CmdInitStructure.SDIO_Response = SDIO_Response_Short;
  SDIO_CmdInitStructure.SDIO_Wait = SDIO_Wait_No;
  SDIO_CmdInitStructure.SDIO_CPSM = SDIO_CPSM_Enable;
  SDIO_SendCommand(&SDIO_CmdInitStructure);

  errorstatus = CmdResp1Error(SD_CMD_SET_BLOCKLEN);

  if (SD_OK != errorstatus)
  {
    return(errorstatus);
  }
    
  SDIO_DataInitStructure.SDIO_DataTimeOut = SD_DATATIMEOUT;
  SDIO_DataInitStructure.SDIO_DataLength = NumberOfBlocks * BlockSize;
  SDIO_DataInitStructure.SDIO_DataBlockSize = (uint32_t) 9 << 4;
  SDIO_DataInitStructure.SDIO_TransferDir = SDIO_TransferDir_ToSDIO;
  SDIO_DataInitStructure.SDIO_TransferMode = SDIO_TransferMode_Block;
  SDIO_DataInitStructure.SDIO_DPSM = SDIO_DPSM_Enable;
  SDIO_DataConfig(&SDIO_DataInitStructure);

  /*!< Send CMD18 READ_MULT_BLOCK with argument data address */
  SDIO_CmdInitStructure.SDIO_Argument = (uint32_t)ReadAddr;
  SDIO_CmdInitStructure.SDIO_CmdIndex = SD_CMD_READ_MULT_BLOCK;
  SDIO_CmdInitStructure.SDIO_Response = SDIO_Response_Short;
  SDIO_CmdInitStructure.SDIO_Wait = SDIO_Wait_No;
  SDIO_CmdInitStructure.SDIO_CPSM = SDIO_CPSM_Enable;
  SDIO_SendCommand(&SDIO_CmdInitStructure);

  errorstatus = CmdResp1Error(SD_CMD_READ_MULT_BLOCK);

  if (errorstatus != SD_OK)
  {
    return(errorstatus);
  }

  return(errorstatus);
}

//--------------------------------------------------------------
SD_Error SD_WaitReadOperation(void)
{
  SD_Error errorstatus = SD_OK;
  uint32_t timeout;

  timeout = SD_DATATIMEOUT;
  
  while ((DMAEndOfTransfer == 0x00) && (TransferEnd == 0) && (TransferError == SD_OK) && (timeout > 0))
  {
    timeout--;
  }
  
  DMAEndOfTransfer = 0x00;

  timeout = SD_DATATIMEOUT;
  
  while(((SDIO->STA & SDIO_FLAG_RXACT)) && (timeout > 0))
  {
    timeout--;  
  }

  if (StopCondition == 1)
  {
    errorstatus = SD_StopTransfer();
    StopCondition = 0;
  }
  
  if ((timeout == 0) && (errorstatus == SD_OK))
  {
    errorstatus = SD_DATA_TIMEOUT;
  }
  
  /*!< Clear all the static flags */
  SDIO_ClearFlag(SDIO_STATIC_FLAGS);

  if (TransferError != SD_OK)
  {
    return(TransferError);
  }
  else
  {
    return(errorstatus);  
  }
}

//--------------------------------------------------------------
SD_Error SD_WriteBlock(uint8_t *writebuff, uint64_t WriteAddr, uint16_t BlockSize)
{
  SD_Error errorstatus = SD_OK;

#if defined (SD_POLLING_MODE)
  uint32_t bytestransferred = 0, count = 0, restwords = 0;
  uint32_t *tempbuff = (uint32_t *)writebuff;
#endif

  TransferError = SD_OK;
  TransferEnd = 0;
  StopCondition = 0;

  SDIO->DCTRL = 0x0;

#if defined (SD_DMA_MODE)
  SDIO_ITConfig(SDIO_IT_DCRCFAIL | SDIO_IT_DTIMEOUT | SDIO_IT_DATAEND | SDIO_IT_RXOVERR | SDIO_IT_STBITERR, ENABLE);
  SD_LowLevel_DMA_TxConfig((uint32_t *)writebuff, BlockSize);
  SDIO_DMACmd(ENABLE);
#endif

  if (CardType == SDIO_HIGH_CAPACITY_SD_CARD)
  {
    BlockSize = 512;
    WriteAddr /= 512;
  }

  /* Set Block Size for Card */ 
  SDIO_CmdInitStructure.SDIO_Argument = (uint32_t) BlockSize;
  SDIO_CmdInitStructure.SDIO_CmdIndex = SD_CMD_SET_BLOCKLEN;
  SDIO_CmdInitStructure.SDIO_Response = SDIO_Response_Short;
  SDIO_CmdInitStructure.SDIO_Wait = SDIO_Wait_No;
  SDIO_CmdInitStructure.SDIO_CPSM = SDIO_CPSM_Enable;
  SDIO_SendCommand(&SDIO_CmdInitStructure);

  errorstatus = CmdResp1Error(SD_CMD_SET_BLOCKLEN);

  if (SD_OK != errorstatus)
  {
    return(errorstatus);
  }

  /*!< Send CMD24 WRITE_SINGLE_BLOCK */
  SDIO_CmdInitStructure.SDIO_Argument = (uint32_t)WriteAddr;
  SDIO_CmdInitStructure.SDIO_CmdIndex = SD_CMD_WRITE_SINGLE_BLOCK;
  SDIO_CmdInitStructure.SDIO_Response = SDIO_Response_Short;
  SDIO_CmdInitStructure.SDIO_Wait = SDIO_Wait_No;
  SDIO_CmdInitStructure.SDIO_CPSM = SDIO_CPSM_Enable;
  SDIO_SendCommand(&SDIO_CmdInitStructure);

  errorstatus = CmdResp1Error(SD_CMD_WRITE_SINGLE_BLOCK);

  if (errorstatus != SD_OK)
  {
    return(errorstatus);
  }

  SDIO_DataInitStructure.SDIO_DataTimeOut = SD_DATATIMEOUT;
  SDIO_DataInitStructure.SDIO_DataLength = BlockSize;
  SDIO_DataInitStructure.SDIO_DataBlockSize = (uint32_t) 9 << 4;
  SDIO_DataInitStructure.SDIO_TransferDir = SDIO_TransferDir_ToCard;
  SDIO_DataInitStructure.SDIO_TransferMode = SDIO_TransferMode_Block;
  SDIO_DataInitStructure.SDIO_DPSM = SDIO_DPSM_Enable;
  SDIO_DataConfig(&SDIO_DataInitStructure);

  /*!< In case of single data block transfer no need of stop command at all */
#if defined (SD_POLLING_MODE) 
  while (!(SDIO->STA & (SDIO_FLAG_DBCKEND | SDIO_FLAG_TXUNDERR | SDIO_FLAG_DCRCFAIL | SDIO_FLAG_DTIMEOUT | SDIO_FLAG_STBITERR)))
  {
    if (SDIO_GetFlagStatus(SDIO_FLAG_TXFIFOHE) != RESET)
    {
      if ((512 - bytestransferred) < 32)
      {
        restwords = ((512 - bytestransferred) % 4 == 0) ? ((512 - bytestransferred) / 4) : (( 512 -  bytestransferred) / 4 + 1);
        for (count = 0; count < restwords; count++, tempbuff++, bytestransferred += 4)
        {
          SDIO_WriteData(*tempbuff);
        }
      }
      else
      {
        for (count = 0; count < 8; count++)
        {
          SDIO_WriteData(*(tempbuff + count));
        }
        tempbuff += 8;
        bytestransferred += 32;
      }
    }
  }
  if (SDIO_GetFlagStatus(SDIO_FLAG_DTIMEOUT) != RESET)
  {
    SDIO_ClearFlag(SDIO_FLAG_DTIMEOUT);
    errorstatus = SD_DATA_TIMEOUT;
    return(errorstatus);
  }
  else if (SDIO_GetFlagStatus(SDIO_FLAG_DCRCFAIL) != RESET)
  {
    SDIO_ClearFlag(SDIO_FLAG_DCRCFAIL);
    errorstatus = SD_DATA_CRC_FAIL;
    return(errorstatus);
  }
  else if (SDIO_GetFlagStatus(SDIO_FLAG_TXUNDERR) != RESET)
  {
    SDIO_ClearFlag(SDIO_FLAG_TXUNDERR);
    errorstatus = SD_TX_UNDERRUN;
    return(errorstatus);
  }
  else if (SDIO_GetFlagStatus(SDIO_FLAG_STBITERR) != RESET)
  {
    SDIO_ClearFlag(SDIO_FLAG_STBITERR);
    errorstatus = SD_START_BIT_ERR;
    return(errorstatus);
  }
  
#endif
  
  return(errorstatus);
}

//--------------------------------------------------------------
SD_Error SD_WriteMultiBlocks(uint8_t *writebuff, uint64_t WriteAddr, uint16_t BlockSize, uint32_t NumberOfBlocks)
{
  SD_Error errorstatus = SD_OK;

  TransferError = SD_OK;
  TransferEnd = 0;
  StopCondition = 1;
  SDIO->DCTRL = 0x0;

  SDIO_ITConfig(SDIO_IT_DCRCFAIL | SDIO_IT_DTIMEOUT | SDIO_IT_DATAEND | SDIO_IT_RXOVERR | SDIO_IT_STBITERR, ENABLE);
  SD_LowLevel_DMA_TxConfig((uint32_t *)writebuff, (NumberOfBlocks * BlockSize));
  SDIO_DMACmd(ENABLE);

  if (CardType == SDIO_HIGH_CAPACITY_SD_CARD)
  {
    BlockSize = 512;
    WriteAddr /= 512;
  }

  /* Set Block Size for Card */ 
  SDIO_CmdInitStructure.SDIO_Argument = (uint32_t) BlockSize;
  SDIO_CmdInitStructure.SDIO_CmdIndex = SD_CMD_SET_BLOCKLEN;
  SDIO_CmdInitStructure.SDIO_Response = SDIO_Response_Short;
  SDIO_CmdInitStructure.SDIO_Wait = SDIO_Wait_No;
  SDIO_CmdInitStructure.SDIO_CPSM = SDIO_CPSM_Enable;
  SDIO_SendCommand(&SDIO_CmdInitStructure);

  errorstatus = CmdResp1Error(SD_CMD_SET_BLOCKLEN);

  if (SD_OK != errorstatus)
  {
    return(errorstatus);
  }
  
  /*!< To improve performance */
  SDIO_CmdInitStructure.SDIO_Argument = (uint32_t) (RCA << 16);
  SDIO_CmdInitStructure.SDIO_CmdIndex = SD_CMD_APP_CMD;
  SDIO_CmdInitStructure.SDIO_Response = SDIO_Response_Short;
  SDIO_CmdInitStructure.SDIO_Wait = SDIO_Wait_No;
  SDIO_CmdInitStructure.SDIO_CPSM = SDIO_CPSM_Enable;
  SDIO_SendCommand(&SDIO_CmdInitStructure);


  errorstatus = CmdResp1Error(SD_CMD_APP_CMD);

  if (errorstatus != SD_OK)
  {
    return(errorstatus);
  }
  /*!< To improve performance */
  SDIO_CmdInitStructure.SDIO_Argument = (uint32_t)NumberOfBlocks;
  SDIO_CmdInitStructure.SDIO_CmdIndex = SD_CMD_SET_BLOCK_COUNT;
  SDIO_CmdInitStructure.SDIO_Response = SDIO_Response_Short;
  SDIO_CmdInitStructure.SDIO_Wait = SDIO_Wait_No;
  SDIO_CmdInitStructure.SDIO_CPSM = SDIO_CPSM_Enable;
  SDIO_SendCommand(&SDIO_CmdInitStructure);

  errorstatus = CmdResp1Error(SD_CMD_SET_BLOCK_COUNT);

  if (errorstatus != SD_OK)
  {
    return(errorstatus);
  }


  /*!< Send CMD25 WRITE_MULT_BLOCK with argument data address */
  SDIO_CmdInitStructure.SDIO_Argument = (uint32_t)WriteAddr;
  SDIO_CmdInitStructure.SDIO_CmdIndex = SD_CMD_WRITE_MULT_BLOCK;
  SDIO_CmdInitStructure.SDIO_Response = SDIO_Response_Short;
  SDIO_CmdInitStructure.SDIO_Wait = SDIO_Wait_No;
  SDIO_CmdInitStructure.SDIO_CPSM = SDIO_CPSM_Enable;
  SDIO_SendCommand(&SDIO_CmdInitStructure);

  errorstatus = CmdResp1Error(SD_CMD_WRITE_MULT_BLOCK);

  if (SD_OK != errorstatus)
  {
    return(errorstatus);
  }

  SDIO_DataInitStructure.SDIO_DataTimeOut = SD_DATATIMEOUT;
  SDIO_DataInitStructure.SDIO_DataLength = NumberOfBlocks * BlockSize;
  SDIO_DataInitStructure.SDIO_DataBlockSize = (uint32_t) 9 << 4;
  SDIO_DataInitStructure.SDIO_TransferDir = SDIO_TransferDir_ToCard;
  SDIO_DataInitStructure.SDIO_TransferMode = SDIO_TransferMode_Block;
  SDIO_DataInitStructure.SDIO_DPSM = SDIO_DPSM_Enable;
  SDIO_DataConfig(&SDIO_DataInitStructure);

  return(errorstatus);
}

//--------------------------------------------------------------
SD_Error SD_WaitWriteOperation(void)
{
  SD_Error errorstatus = SD_OK;
  uint32_t timeout;

  timeout = SD_DATATIMEOUT;
  
  while ((DMAEndOfTransfer == 0x00) && (TransferEnd == 0) && (TransferError == SD_OK) && (timeout > 0))
  {
    timeout--;
  }
  
  DMAEndOfTransfer = 0x00;

  timeout = SD_DATATIMEOUT;
  
  while(((SDIO->STA & SDIO_FLAG_TXACT)) && (timeout > 0))
  {
    timeout--;  
  }

  if (StopCondition == 1)
  {
    errorstatus = SD_StopTransfer();
    StopCondition = 0;
  }
  
  if ((timeout == 0) && (errorstatus == SD_OK))
  {
    errorstatus = SD_DATA_TIMEOUT;
  }
  
  /*!< Clear all the static flags */
  SDIO_ClearFlag(SDIO_STATIC_FLAGS);
  
  if (TransferError != SD_OK)
  {
    return(TransferError);
  }
  else
  {
    return(errorstatus);
  }
}

//--------------------------------------------------------------
SDTransferState SD_GetTransferState(void)
{
  if (SDIO->STA & (SDIO_FLAG_TXACT | SDIO_FLAG_RXACT))
  {
    return(SD_TRANSFER_BUSY);
  }
  else
  {
    return(SD_TRANSFER_OK);
  }
}

//--------------------------------------------------------------
SD_Error SD_StopTransfer(void)
{
  SD_Error errorstatus = SD_OK;

  /*!< Send CMD12 STOP_TRANSMISSION  */
  SDIO_CmdInitStructure.SDIO_Argument = 0x0;
  SDIO_CmdInitStructure.SDIO_CmdIndex = SD_CMD_STOP_TRANSMISSION;
  SDIO_CmdInitStructure.SDIO_Response = SDIO_Response_Short;
  SDIO_CmdInitStructure.SDIO_Wait = SDIO_Wait_No;
  SDIO_CmdInitStructure.SDIO_CPSM = SDIO_CPSM_Enable;
  SDIO_SendCommand(&SDIO_CmdInitStructure);

  errorstatus = CmdResp1Error(SD_CMD_STOP_TRANSMISSION);

  return(errorstatus);
}

//--------------------------------------------------------------
SD_Error SD_Erase(uint64_t startaddr, uint64_t endaddr)
{
  SD_Error errorstatus = SD_OK;
  uint32_t delay = 0;
  __IO uint32_t maxdelay = 0;
  uint8_t cardstate = 0;

  /*!< Check if the card coomnd class supports erase command */
  if (((CSD_Tab[1] >> 20) & SD_CCCC_ERASE) == 0)
  {
    errorstatus = SD_REQUEST_NOT_APPLICABLE;
    return(errorstatus);
  }

  maxdelay = 120000 / ((SDIO->CLKCR & 0xFF) + 2);

  if (SDIO_GetResponse(SDIO_RESP1) & SD_CARD_LOCKED)
  {
    errorstatus = SD_LOCK_UNLOCK_FAILED;
    return(errorstatus);
  }

  if (CardType == SDIO_HIGH_CAPACITY_SD_CARD)
  {
    startaddr /= 512;
    endaddr /= 512;
  }
  
  /*!< According to sd-card spec 1.0 ERASE_GROUP_START (CMD32) and erase_group_end(CMD33) */
  if ((SDIO_STD_CAPACITY_SD_CARD_V1_1 == CardType) || (SDIO_STD_CAPACITY_SD_CARD_V2_0 == CardType) || (SDIO_HIGH_CAPACITY_SD_CARD == CardType))
  {
    /*!< Send CMD32 SD_ERASE_GRP_START with argument as addr  */
    SDIO_CmdInitStructure.SDIO_Argument =(uint32_t)startaddr;
    SDIO_CmdInitStructure.SDIO_CmdIndex = SD_CMD_SD_ERASE_GRP_START;
    SDIO_CmdInitStructure.SDIO_Response = SDIO_Response_Short;
    SDIO_CmdInitStructure.SDIO_Wait = SDIO_Wait_No;
    SDIO_CmdInitStructure.SDIO_CPSM = SDIO_CPSM_Enable;
    SDIO_SendCommand(&SDIO_CmdInitStructure);

    errorstatus = CmdResp1Error(SD_CMD_SD_ERASE_GRP_START);
    if (errorstatus != SD_OK)
    {
      return(errorstatus);
    }

    /*!< Send CMD33 SD_ERASE_GRP_END with argument as addr  */
    SDIO_CmdInitStructure.SDIO_Argument = (uint32_t)endaddr;
    SDIO_CmdInitStructure.SDIO_CmdIndex = SD_CMD_SD_ERASE_GRP_END;
    SDIO_CmdInitStructure.SDIO_Response = SDIO_Response_Short;
    SDIO_CmdInitStructure.SDIO_Wait = SDIO_Wait_No;
    SDIO_CmdInitStructure.SDIO_CPSM = SDIO_CPSM_Enable;
    SDIO_SendCommand(&SDIO_CmdInitStructure);

    errorstatus = CmdResp1Error(SD_CMD_SD_ERASE_GRP_END);
    if (errorstatus != SD_OK)
    {
      return(errorstatus);
    }
  }

  /*!< Send CMD38 ERASE */
  SDIO_CmdInitStructure.SDIO_Argument = 0;
  SDIO_CmdInitStructure.SDIO_CmdIndex = SD_CMD_ERASE;
  SDIO_CmdInitStructure.SDIO_Response = SDIO_Response_Short;
  SDIO_CmdInitStructure.SDIO_Wait = SDIO_Wait_No;
  SDIO_CmdInitStructure.SDIO_CPSM = SDIO_CPSM_Enable;
  SDIO_SendCommand(&SDIO_CmdInitStructure);

  errorstatus = CmdResp1Error(SD_CMD_ERASE);

  if (errorstatus != SD_OK)
  {
    return(errorstatus);
  }

  for (delay = 0; delay < maxdelay; delay++)
  {}

  /*!< Wait till the card is in programming state */
  errorstatus = IsCardProgramming(&cardstate);
  delay = SD_DATATIMEOUT;
  while ((delay > 0) && (errorstatus == SD_OK) && ((SD_CARD_PROGRAMMING == cardstate) || (SD_CARD_RECEIVING == cardstate)))
  {
    errorstatus = IsCardProgramming(&cardstate);
    delay--;
  }

  return(errorstatus);
}

//--------------------------------------------------------------
SD_Error SD_SendStatus(uint32_t *pcardstatus)
{
  SD_Error errorstatus = SD_OK;

  if (pcardstatus == NULL)
  {
    errorstatus = SD_INVALID_PARAMETER;
    return(errorstatus);
  }

  SDIO_CmdInitStructure.SDIO_Argument = (uint32_t) RCA << 16;
  SDIO_CmdInitStructure.SDIO_CmdIndex = SD_CMD_SEND_STATUS;
  SDIO_CmdInitStructure.SDIO_Response = SDIO_Response_Short;
  SDIO_CmdInitStructure.SDIO_Wait = SDIO_Wait_No;
  SDIO_CmdInitStructure.SDIO_CPSM = SDIO_CPSM_Enable;
  SDIO_SendCommand(&SDIO_CmdInitStructure);

  errorstatus = CmdResp1Error(SD_CMD_SEND_STATUS);

  if (errorstatus != SD_OK)
  {
    return(errorstatus);
  }

  *pcardstatus = SDIO_GetResponse(SDIO_RESP1);

  return(errorstatus);
}

//--------------------------------------------------------------
SD_Error SD_SendSDStatus(uint32_t *psdstatus)
{
  SD_Error errorstatus = SD_OK;
  uint32_t count = 0;

  if (SDIO_GetResponse(SDIO_RESP1) & SD_CARD_LOCKED)
  {
    errorstatus = SD_LOCK_UNLOCK_FAILED;
    return(errorstatus);
  }

  /*!< Set block size for card if it is not equal to current block size for card. */
  SDIO_CmdInitStructure.SDIO_Argument = 64;
  SDIO_CmdInitStructure.SDIO_CmdIndex = SD_CMD_SET_BLOCKLEN;
  SDIO_CmdInitStructure.SDIO_Response = SDIO_Response_Short;
  SDIO_CmdInitStructure.SDIO_Wait = SDIO_Wait_No;
  SDIO_CmdInitStructure.SDIO_CPSM = SDIO_CPSM_Enable;
  SDIO_SendCommand(&SDIO_CmdInitStructure);

  errorstatus = CmdResp1Error(SD_CMD_SET_BLOCKLEN);

  if (errorstatus != SD_OK)
  {
    return(errorstatus);
  }

  /*!< CMD55 */
  SDIO_CmdInitStructure.SDIO_Argument = (uint32_t) RCA << 16;
  SDIO_CmdInitStructure.SDIO_CmdIndex = SD_CMD_APP_CMD;
  SDIO_CmdInitStructure.SDIO_Response = SDIO_Response_Short;
  SDIO_CmdInitStructure.SDIO_Wait = SDIO_Wait_No;
  SDIO_CmdInitStructure.SDIO_CPSM = SDIO_CPSM_Enable;
  SDIO_SendCommand(&SDIO_CmdInitStructure);
  errorstatus = CmdResp1Error(SD_CMD_APP_CMD);

  if (errorstatus != SD_OK)
  {
    return(errorstatus);
  }

  SDIO_DataInitStructure.SDIO_DataTimeOut = SD_DATATIMEOUT;
  SDIO_DataInitStructure.SDIO_DataLength = 64;
  SDIO_DataInitStructure.SDIO_DataBlockSize = SDIO_DataBlockSize_64b;
  SDIO_DataInitStructure.SDIO_TransferDir = SDIO_TransferDir_ToSDIO;
  SDIO_DataInitStructure.SDIO_TransferMode = SDIO_TransferMode_Block;
  SDIO_DataInitStructure.SDIO_DPSM = SDIO_DPSM_Enable;
  SDIO_DataConfig(&SDIO_DataInitStructure);

  /*!< Send ACMD13 SD_APP_STAUS  with argument as card's RCA.*/
  SDIO_CmdInitStructure.SDIO_Argument = 0;
  SDIO_CmdInitStructure.SDIO_CmdIndex = SD_CMD_SD_APP_STAUS;
  SDIO_CmdInitStructure.SDIO_Response = SDIO_Response_Short;
  SDIO_CmdInitStructure.SDIO_Wait = SDIO_Wait_No;
  SDIO_CmdInitStructure.SDIO_CPSM = SDIO_CPSM_Enable;
  SDIO_SendCommand(&SDIO_CmdInitStructure);
  errorstatus = CmdResp1Error(SD_CMD_SD_APP_STAUS);

  if (errorstatus != SD_OK)
  {
    return(errorstatus);
  }

  while (!(SDIO->STA &(SDIO_FLAG_RXOVERR | SDIO_FLAG_DCRCFAIL | SDIO_FLAG_DTIMEOUT | SDIO_FLAG_DBCKEND | SDIO_FLAG_STBITERR)))
  {
    if (SDIO_GetFlagStatus(SDIO_FLAG_RXFIFOHF) != RESET)
    {
      for (count = 0; count < 8; count++)
      {
        *(psdstatus + count) = SDIO_ReadData();
      }
      psdstatus += 8;
    }
  }

  if (SDIO_GetFlagStatus(SDIO_FLAG_DTIMEOUT) != RESET)
  {
    SDIO_ClearFlag(SDIO_FLAG_DTIMEOUT);
    errorstatus = SD_DATA_TIMEOUT;
    return(errorstatus);
  }
  else if (SDIO_GetFlagStatus(SDIO_FLAG_DCRCFAIL) != RESET)
  {
    SDIO_ClearFlag(SDIO_FLAG_DCRCFAIL);
    errorstatus = SD_DATA_CRC_FAIL;
    return(errorstatus);
  }
  else if (SDIO_GetFlagStatus(SDIO_FLAG_RXOVERR) != RESET)
  {
    SDIO_ClearFlag(SDIO_FLAG_RXOVERR);
    errorstatus = SD_RX_OVERRUN;
    return(errorstatus);
  }
  else if (SDIO_GetFlagStatus(SDIO_FLAG_STBITERR) != RESET)
  {
    SDIO_ClearFlag(SDIO_FLAG_STBITERR);
    errorstatus = SD_START_BIT_ERR;
    return(errorstatus);
  }

  count = SD_DATATIMEOUT;
  while ((SDIO_GetFlagStatus(SDIO_FLAG_RXDAVL) != RESET) && (count > 0))
  {
    *psdstatus = SDIO_ReadData();
    psdstatus++;
    count--;
  }
  /*!< Clear all the static status flags*/
  SDIO_ClearFlag(SDIO_STATIC_FLAGS);

  return(errorstatus);
}

//--------------------------------------------------------------
SD_Error SD_ProcessIRQSrc(void)
{ 
  if (SDIO_GetITStatus(SDIO_IT_DATAEND) != RESET)
  {
    TransferError = SD_OK;
    SDIO_ClearITPendingBit(SDIO_IT_DATAEND);
    TransferEnd = 1;
  }  
  else if (SDIO_GetITStatus(SDIO_IT_DCRCFAIL) != RESET)
  {
    SDIO_ClearITPendingBit(SDIO_IT_DCRCFAIL);
    #if SDIO_STM32F4_REV==1
      // Workaround for CRC_BUG in Revision-A CPU
      TransferError = SD_DATA_CRC_FAIL;
    #endif
  }
  else if (SDIO_GetITStatus(SDIO_IT_DTIMEOUT) != RESET)
  {
    SDIO_ClearITPendingBit(SDIO_IT_DTIMEOUT);
    TransferError = SD_DATA_TIMEOUT;
  }
  else if (SDIO_GetITStatus(SDIO_IT_RXOVERR) != RESET)
  {
    SDIO_ClearITPendingBit(SDIO_IT_RXOVERR);
    TransferError = SD_RX_OVERRUN;
  }
  else if (SDIO_GetITStatus(SDIO_IT_TXUNDERR) != RESET)
  {
    SDIO_ClearITPendingBit(SDIO_IT_TXUNDERR);
    TransferError = SD_TX_UNDERRUN;
  }
  else if (SDIO_GetITStatus(SDIO_IT_STBITERR) != RESET)
  {
    SDIO_ClearITPendingBit(SDIO_IT_STBITERR);
    TransferError = SD_START_BIT_ERR;
  }

  SDIO_ITConfig(SDIO_IT_DCRCFAIL | SDIO_IT_DTIMEOUT | SDIO_IT_DATAEND |
                SDIO_IT_TXFIFOHE | SDIO_IT_RXFIFOHF | SDIO_IT_TXUNDERR |
                SDIO_IT_RXOVERR | SDIO_IT_STBITERR, DISABLE);
  return(TransferError);
}

//--------------------------------------------------------------
void SD_ProcessDMAIRQ(void)
{
  if(DMA2->LISR & SD_SDIO_DMA_FLAG_TCIF)
  {
    DMAEndOfTransfer = 0x01;
    DMA_ClearFlag(SD_SDIO_DMA_STREAM, SD_SDIO_DMA_FLAG_TCIF|SD_SDIO_DMA_FLAG_FEIF);
  }
}

//--------------------------------------------------------------
static SD_Error CmdError(void)
{
  SD_Error errorstatus = SD_OK;
  uint32_t timeout;

  timeout = SDIO_CMD0TIMEOUT; /*!< 10000 */

  while ((timeout > 0) && (SDIO_GetFlagStatus(SDIO_FLAG_CMDSENT) == RESET))
  {
    timeout--;
  }

  if (timeout == 0)
  {
    errorstatus = SD_CMD_RSP_TIMEOUT;
    return(errorstatus);
  }

  /*!< Clear all the static flags */
  SDIO_ClearFlag(SDIO_STATIC_FLAGS);

  return(errorstatus);
}

//--------------------------------------------------------------
static SD_Error CmdResp7Error(void)
{
  SD_Error errorstatus = SD_OK;
  uint32_t status;
  uint32_t timeout = SDIO_CMD0TIMEOUT;

  status = SDIO->STA;

  while (!(status & (SDIO_FLAG_CCRCFAIL | SDIO_FLAG_CMDREND | SDIO_FLAG_CTIMEOUT)) && (timeout > 0))
  {
    timeout--;
    status = SDIO->STA;
  }

  if ((timeout == 0) || (status & SDIO_FLAG_CTIMEOUT))
  {
    /*!< Card is not V2.0 complient or card does not support the set voltage range */
    errorstatus = SD_CMD_RSP_TIMEOUT;
    SDIO_ClearFlag(SDIO_FLAG_CTIMEOUT);
    return(errorstatus);
  }

  if (status & SDIO_FLAG_CMDREND)
  {
    /*!< Card is SD V2.0 compliant */
    errorstatus = SD_OK;
    SDIO_ClearFlag(SDIO_FLAG_CMDREND);
    return(errorstatus);
  }
  return(errorstatus);
}

//--------------------------------------------------------------
static SD_Error CmdResp1Error(uint8_t cmd)
{
  SD_Error errorstatus = SD_OK;
  uint32_t status;
  uint32_t response_r1;

  status = SDIO->STA;

  while (!(status & (SDIO_FLAG_CCRCFAIL | SDIO_FLAG_CMDREND | SDIO_FLAG_CTIMEOUT)))
  {
    status = SDIO->STA;
  }

  if (status & SDIO_FLAG_CTIMEOUT)
  {
    errorstatus = SD_CMD_RSP_TIMEOUT;
    SDIO_ClearFlag(SDIO_FLAG_CTIMEOUT);
    return(errorstatus);
  }
  else if (status & SDIO_FLAG_CCRCFAIL)
  {
    errorstatus = SD_CMD_CRC_FAIL;
    SDIO_ClearFlag(SDIO_FLAG_CCRCFAIL);
    return(errorstatus);
  }

  /*!< Check response received is of desired command */
  if (SDIO_GetCommandResponse() != cmd)
  {
    errorstatus = SD_ILLEGAL_CMD;
    return(errorstatus);
  }

  /*!< Clear all the static flags */
  SDIO_ClearFlag(SDIO_STATIC_FLAGS);

  /*!< We have received response, retrieve it for analysis  */
  response_r1 = SDIO_GetResponse(SDIO_RESP1);

  if ((response_r1 & SD_OCR_ERRORBITS) == SD_ALLZERO)
  {
    return(errorstatus);
  }

  if (response_r1 & SD_OCR_ADDR_OUT_OF_RANGE)
  {
    return(SD_ADDR_OUT_OF_RANGE);
  }

  if (response_r1 & SD_OCR_ADDR_MISALIGNED)
  {
    return(SD_ADDR_MISALIGNED);
  }

  if (response_r1 & SD_OCR_BLOCK_LEN_ERR)
  {
    return(SD_BLOCK_LEN_ERR);
  }

  if (response_r1 & SD_OCR_ERASE_SEQ_ERR)
  {
    return(SD_ERASE_SEQ_ERR);
  }

  if (response_r1 & SD_OCR_BAD_ERASE_PARAM)
  {
    return(SD_BAD_ERASE_PARAM);
  }

  if (response_r1 & SD_OCR_WRITE_PROT_VIOLATION)
  {
    return(SD_WRITE_PROT_VIOLATION);
  }

  if (response_r1 & SD_OCR_LOCK_UNLOCK_FAILED)
  {
    return(SD_LOCK_UNLOCK_FAILED);
  }

  if (response_r1 & SD_OCR_COM_CRC_FAILED)
  {
    return(SD_COM_CRC_FAILED);
  }

  if (response_r1 & SD_OCR_ILLEGAL_CMD)
  {
    return(SD_ILLEGAL_CMD);
  }

  if (response_r1 & SD_OCR_CARD_ECC_FAILED)
  {
    return(SD_CARD_ECC_FAILED);
  }

  if (response_r1 & SD_OCR_CC_ERROR)
  {
    return(SD_CC_ERROR);
  }

  if (response_r1 & SD_OCR_GENERAL_UNKNOWN_ERROR)
  {
    return(SD_GENERAL_UNKNOWN_ERROR);
  }

  if (response_r1 & SD_OCR_STREAM_READ_UNDERRUN)
  {
    return(SD_STREAM_READ_UNDERRUN);
  }

  if (response_r1 & SD_OCR_STREAM_WRITE_OVERRUN)
  {
    return(SD_STREAM_WRITE_OVERRUN);
  }

  if (response_r1 & SD_OCR_CID_CSD_OVERWRIETE)
  {
    return(SD_CID_CSD_OVERWRITE);
  }

  if (response_r1 & SD_OCR_WP_ERASE_SKIP)
  {
    return(SD_WP_ERASE_SKIP);
  }

  if (response_r1 & SD_OCR_CARD_ECC_DISABLED)
  {
    return(SD_CARD_ECC_DISABLED);
  }

  if (response_r1 & SD_OCR_ERASE_RESET)
  {
    return(SD_ERASE_RESET);
  }

  if (response_r1 & SD_OCR_AKE_SEQ_ERROR)
  {
    return(SD_AKE_SEQ_ERROR);
  }
  return(errorstatus);
}

//--------------------------------------------------------------
static SD_Error CmdResp3Error(void)
{
  SD_Error errorstatus = SD_OK;
  uint32_t status;

  status = SDIO->STA;

  while (!(status & (SDIO_FLAG_CCRCFAIL | SDIO_FLAG_CMDREND | SDIO_FLAG_CTIMEOUT)))
  {
    status = SDIO->STA;
  }

  if (status & SDIO_FLAG_CTIMEOUT)
  {
    errorstatus = SD_CMD_RSP_TIMEOUT;
    SDIO_ClearFlag(SDIO_FLAG_CTIMEOUT);
    return(errorstatus);
  }
  /*!< Clear all the static flags */
  SDIO_ClearFlag(SDIO_STATIC_FLAGS);
  return(errorstatus);
}

//--------------------------------------------------------------
static SD_Error CmdResp2Error(void)
{
  SD_Error errorstatus = SD_OK;
  uint32_t status;

  status = SDIO->STA;

  while (!(status & (SDIO_FLAG_CCRCFAIL | SDIO_FLAG_CTIMEOUT | SDIO_FLAG_CMDREND)))
  {
    status = SDIO->STA;
  }

  if (status & SDIO_FLAG_CTIMEOUT)
  {
    errorstatus = SD_CMD_RSP_TIMEOUT;
    SDIO_ClearFlag(SDIO_FLAG_CTIMEOUT);
    return(errorstatus);
  }
  else if (status & SDIO_FLAG_CCRCFAIL)
  {
    errorstatus = SD_CMD_CRC_FAIL;
    SDIO_ClearFlag(SDIO_FLAG_CCRCFAIL);
    return(errorstatus);
  }

  /*!< Clear all the static flags */
  SDIO_ClearFlag(SDIO_STATIC_FLAGS);

  return(errorstatus);
}

//--------------------------------------------------------------
static SD_Error CmdResp6Error(uint8_t cmd, uint16_t *prca)
{
  SD_Error errorstatus = SD_OK;
  uint32_t status;
  uint32_t response_r1;

  status = SDIO->STA;

  while (!(status & (SDIO_FLAG_CCRCFAIL | SDIO_FLAG_CTIMEOUT | SDIO_FLAG_CMDREND)))
  {
    status = SDIO->STA;
  }

  if (status & SDIO_FLAG_CTIMEOUT)
  {
    errorstatus = SD_CMD_RSP_TIMEOUT;
    SDIO_ClearFlag(SDIO_FLAG_CTIMEOUT);
    return(errorstatus);
  }
  else if (status & SDIO_FLAG_CCRCFAIL)
  {
    errorstatus = SD_CMD_CRC_FAIL;
    SDIO_ClearFlag(SDIO_FLAG_CCRCFAIL);
    return(errorstatus);
  }

  /*!< Check response received is of desired command */
  if (SDIO_GetCommandResponse() != cmd)
  {
    errorstatus = SD_ILLEGAL_CMD;
    return(errorstatus);
  }

  /*!< Clear all the static flags */
  SDIO_ClearFlag(SDIO_STATIC_FLAGS);

  /*!< We have received response, retrieve it.  */
  response_r1 = SDIO_GetResponse(SDIO_RESP1);

  if (SD_ALLZERO == (response_r1 & (SD_R6_GENERAL_UNKNOWN_ERROR | SD_R6_ILLEGAL_CMD | SD_R6_COM_CRC_FAILED)))
  {
    *prca = (uint16_t) (response_r1 >> 16);
    return(errorstatus);
  }

  if (response_r1 & SD_R6_GENERAL_UNKNOWN_ERROR)
  {
    return(SD_GENERAL_UNKNOWN_ERROR);
  }

  if (response_r1 & SD_R6_ILLEGAL_CMD)
  {
    return(SD_ILLEGAL_CMD);
  }

  if (response_r1 & SD_R6_COM_CRC_FAILED)
  {
    return(SD_COM_CRC_FAILED);
  }

  return(errorstatus);
}

//--------------------------------------------------------------
static SD_Error SDEnWideBus(FunctionalState NewState)
{
  SD_Error errorstatus = SD_OK;

  uint32_t scr[2] = {0, 0};

  if (SDIO_GetResponse(SDIO_RESP1) & SD_CARD_LOCKED)
  {
    errorstatus = SD_LOCK_UNLOCK_FAILED;
    return(errorstatus);
  }

  /*!< Get SCR Register */
  errorstatus = FindSCR(RCA, scr);

  if (errorstatus != SD_OK)
  {
    return(errorstatus);
  }

  /*!< If wide bus operation to be enabled */
  if (NewState == ENABLE)
  {
    /*!< If requested card supports wide bus operation */
    if ((scr[1] & SD_WIDE_BUS_SUPPORT) != SD_ALLZERO)
    {
      /*!< Send CMD55 APP_CMD with argument as card's RCA.*/
      SDIO_CmdInitStructure.SDIO_Argument = (uint32_t) RCA << 16;
      SDIO_CmdInitStructure.SDIO_CmdIndex = SD_CMD_APP_CMD;
      SDIO_CmdInitStructure.SDIO_Response = SDIO_Response_Short;
      SDIO_CmdInitStructure.SDIO_Wait = SDIO_Wait_No;
      SDIO_CmdInitStructure.SDIO_CPSM = SDIO_CPSM_Enable;
      SDIO_SendCommand(&SDIO_CmdInitStructure);

      errorstatus = CmdResp1Error(SD_CMD_APP_CMD);

      if (errorstatus != SD_OK)
      {
        return(errorstatus);
      }

      /*!< Send ACMD6 APP_CMD with argument as 2 for wide bus mode */
      SDIO_CmdInitStructure.SDIO_Argument = 0x2;
      SDIO_CmdInitStructure.SDIO_CmdIndex = SD_CMD_APP_SD_SET_BUSWIDTH;
      SDIO_CmdInitStructure.SDIO_Response = SDIO_Response_Short;
      SDIO_CmdInitStructure.SDIO_Wait = SDIO_Wait_No;
      SDIO_CmdInitStructure.SDIO_CPSM = SDIO_CPSM_Enable;
      SDIO_SendCommand(&SDIO_CmdInitStructure);

      errorstatus = CmdResp1Error(SD_CMD_APP_SD_SET_BUSWIDTH);

      if (errorstatus != SD_OK)
      {
        return(errorstatus);
      }
      return(errorstatus);
    }
    else
    {
      errorstatus = SD_REQUEST_NOT_APPLICABLE;
      return(errorstatus);
    }
  }   /*!< If wide bus operation to be disabled */
  else
  {
    /*!< If requested card supports 1 bit mode operation */
    if ((scr[1] & SD_SINGLE_BUS_SUPPORT) != SD_ALLZERO)
    {
      /*!< Send CMD55 APP_CMD with argument as card's RCA.*/
      SDIO_CmdInitStructure.SDIO_Argument = (uint32_t) RCA << 16;
      SDIO_CmdInitStructure.SDIO_CmdIndex = SD_CMD_APP_CMD;
      SDIO_CmdInitStructure.SDIO_Response = SDIO_Response_Short;
      SDIO_CmdInitStructure.SDIO_Wait = SDIO_Wait_No;
      SDIO_CmdInitStructure.SDIO_CPSM = SDIO_CPSM_Enable;
      SDIO_SendCommand(&SDIO_CmdInitStructure);


      errorstatus = CmdResp1Error(SD_CMD_APP_CMD);

      if (errorstatus != SD_OK)
      {
        return(errorstatus);
      }

      /*!< Send ACMD6 APP_CMD with argument as 2 for wide bus mode */
      SDIO_CmdInitStructure.SDIO_Argument = 0x00;
      SDIO_CmdInitStructure.SDIO_CmdIndex = SD_CMD_APP_SD_SET_BUSWIDTH;
      SDIO_CmdInitStructure.SDIO_Response = SDIO_Response_Short;
      SDIO_CmdInitStructure.SDIO_Wait = SDIO_Wait_No;
      SDIO_CmdInitStructure.SDIO_CPSM = SDIO_CPSM_Enable;
      SDIO_SendCommand(&SDIO_CmdInitStructure);

      errorstatus = CmdResp1Error(SD_CMD_APP_SD_SET_BUSWIDTH);

      if (errorstatus != SD_OK)
      {
        return(errorstatus);
      }

      return(errorstatus);
    }
    else
    {
      errorstatus = SD_REQUEST_NOT_APPLICABLE;
      return(errorstatus);
    }
  }
}

//--------------------------------------------------------------
static SD_Error IsCardProgramming(uint8_t *pstatus)
{
  SD_Error errorstatus = SD_OK;
  __IO uint32_t respR1 = 0, status = 0;

  SDIO_CmdInitStructure.SDIO_Argument = (uint32_t) RCA << 16;
  SDIO_CmdInitStructure.SDIO_CmdIndex = SD_CMD_SEND_STATUS;
  SDIO_CmdInitStructure.SDIO_Response = SDIO_Response_Short;
  SDIO_CmdInitStructure.SDIO_Wait = SDIO_Wait_No;
  SDIO_CmdInitStructure.SDIO_CPSM = SDIO_CPSM_Enable;
  SDIO_SendCommand(&SDIO_CmdInitStructure);

  status = SDIO->STA;
  while (!(status & (SDIO_FLAG_CCRCFAIL | SDIO_FLAG_CMDREND | SDIO_FLAG_CTIMEOUT)))
  {
    status = SDIO->STA;
  }

  if (status & SDIO_FLAG_CTIMEOUT)
  {
    errorstatus = SD_CMD_RSP_TIMEOUT;
    SDIO_ClearFlag(SDIO_FLAG_CTIMEOUT);
    return(errorstatus);
  }
  else if (status & SDIO_FLAG_CCRCFAIL)
  {
    errorstatus = SD_CMD_CRC_FAIL;
    SDIO_ClearFlag(SDIO_FLAG_CCRCFAIL);
    return(errorstatus);
  }

  status = (uint32_t)SDIO_GetCommandResponse();

  /*!< Check response received is of desired command */
  if (status != SD_CMD_SEND_STATUS)
  {
    errorstatus = SD_ILLEGAL_CMD;
    return(errorstatus);
  }

  /*!< Clear all the static flags */
  SDIO_ClearFlag(SDIO_STATIC_FLAGS);


  /*!< We have received response, retrieve it for analysis  */
  respR1 = SDIO_GetResponse(SDIO_RESP1);

  /*!< Find out card status */
  *pstatus = (uint8_t) ((respR1 >> 9) & 0x0000000F);

  if ((respR1 & SD_OCR_ERRORBITS) == SD_ALLZERO)
  {
    return(errorstatus);
  }

  if (respR1 & SD_OCR_ADDR_OUT_OF_RANGE)
  {
    return(SD_ADDR_OUT_OF_RANGE);
  }

  if (respR1 & SD_OCR_ADDR_MISALIGNED)
  {
    return(SD_ADDR_MISALIGNED);
  }

  if (respR1 & SD_OCR_BLOCK_LEN_ERR)
  {
    return(SD_BLOCK_LEN_ERR);
  }

  if (respR1 & SD_OCR_ERASE_SEQ_ERR)
  {
    return(SD_ERASE_SEQ_ERR);
  }

  if (respR1 & SD_OCR_BAD_ERASE_PARAM)
  {
    return(SD_BAD_ERASE_PARAM);
  }

  if (respR1 & SD_OCR_WRITE_PROT_VIOLATION)
  {
    return(SD_WRITE_PROT_VIOLATION);
  }

  if (respR1 & SD_OCR_LOCK_UNLOCK_FAILED)
  {
    return(SD_LOCK_UNLOCK_FAILED);
  }

  if (respR1 & SD_OCR_COM_CRC_FAILED)
  {
    return(SD_COM_CRC_FAILED);
  }

  if (respR1 & SD_OCR_ILLEGAL_CMD)
  {
    return(SD_ILLEGAL_CMD);
  }

  if (respR1 & SD_OCR_CARD_ECC_FAILED)
  {
    return(SD_CARD_ECC_FAILED);
  }

  if (respR1 & SD_OCR_CC_ERROR)
  {
    return(SD_CC_ERROR);
  }

  if (respR1 & SD_OCR_GENERAL_UNKNOWN_ERROR)
  {
    return(SD_GENERAL_UNKNOWN_ERROR);
  }

  if (respR1 & SD_OCR_STREAM_READ_UNDERRUN)
  {
    return(SD_STREAM_READ_UNDERRUN);
  }

  if (respR1 & SD_OCR_STREAM_WRITE_OVERRUN)
  {
    return(SD_STREAM_WRITE_OVERRUN);
  }

  if (respR1 & SD_OCR_CID_CSD_OVERWRIETE)
  {
    return(SD_CID_CSD_OVERWRITE);
  }

  if (respR1 & SD_OCR_WP_ERASE_SKIP)
  {
    return(SD_WP_ERASE_SKIP);
  }

  if (respR1 & SD_OCR_CARD_ECC_DISABLED)
  {
    return(SD_CARD_ECC_DISABLED);
  }

  if (respR1 & SD_OCR_ERASE_RESET)
  {
    return(SD_ERASE_RESET);
  }

  if (respR1 & SD_OCR_AKE_SEQ_ERROR)
  {
    return(SD_AKE_SEQ_ERROR);
  }

  return(errorstatus);
}

//--------------------------------------------------------------
static SD_Error FindSCR(uint16_t rca, uint32_t *pscr)
{
  uint32_t index = 0;
  SD_Error errorstatus = SD_OK;
  uint32_t tempscr[2] = {0, 0};

  /*!< Set Block Size To 8 Bytes */
  /*!< Send CMD55 APP_CMD with argument as card's RCA */
  SDIO_CmdInitStructure.SDIO_Argument = (uint32_t)8;
  SDIO_CmdInitStructure.SDIO_CmdIndex = SD_CMD_SET_BLOCKLEN;
  SDIO_CmdInitStructure.SDIO_Response = SDIO_Response_Short;
  SDIO_CmdInitStructure.SDIO_Wait = SDIO_Wait_No;
  SDIO_CmdInitStructure.SDIO_CPSM = SDIO_CPSM_Enable;
  SDIO_SendCommand(&SDIO_CmdInitStructure);

  errorstatus = CmdResp1Error(SD_CMD_SET_BLOCKLEN);

  if (errorstatus != SD_OK)
  {
    return(errorstatus);
  }

  /*!< Send CMD55 APP_CMD with argument as card's RCA */
  SDIO_CmdInitStructure.SDIO_Argument = (uint32_t) RCA << 16;
  SDIO_CmdInitStructure.SDIO_CmdIndex = SD_CMD_APP_CMD;
  SDIO_CmdInitStructure.SDIO_Response = SDIO_Response_Short;
  SDIO_CmdInitStructure.SDIO_Wait = SDIO_Wait_No;
  SDIO_CmdInitStructure.SDIO_CPSM = SDIO_CPSM_Enable;
  SDIO_SendCommand(&SDIO_CmdInitStructure);

  errorstatus = CmdResp1Error(SD_CMD_APP_CMD);

  if (errorstatus != SD_OK)
  {
    return(errorstatus);
  }
  SDIO_DataInitStructure.SDIO_DataTimeOut = SD_DATATIMEOUT;
  SDIO_DataInitStructure.SDIO_DataLength = 8;
  SDIO_DataInitStructure.SDIO_DataBlockSize = SDIO_DataBlockSize_8b;
  SDIO_DataInitStructure.SDIO_TransferDir = SDIO_TransferDir_ToSDIO;
  SDIO_DataInitStructure.SDIO_TransferMode = SDIO_TransferMode_Block;
  SDIO_DataInitStructure.SDIO_DPSM = SDIO_DPSM_Enable;
  SDIO_DataConfig(&SDIO_DataInitStructure);


  /*!< Send ACMD51 SD_APP_SEND_SCR with argument as 0 */
  SDIO_CmdInitStructure.SDIO_Argument = 0x0;
  SDIO_CmdInitStructure.SDIO_CmdIndex = SD_CMD_SD_APP_SEND_SCR;
  SDIO_CmdInitStructure.SDIO_Response = SDIO_Response_Short;
  SDIO_CmdInitStructure.SDIO_Wait = SDIO_Wait_No;
  SDIO_CmdInitStructure.SDIO_CPSM = SDIO_CPSM_Enable;
  SDIO_SendCommand(&SDIO_CmdInitStructure);

  errorstatus = CmdResp1Error(SD_CMD_SD_APP_SEND_SCR);

  if (errorstatus != SD_OK)
  {
    return(errorstatus);
  }

  while (!(SDIO->STA & (SDIO_FLAG_RXOVERR | SDIO_FLAG_DCRCFAIL | SDIO_FLAG_DTIMEOUT | SDIO_FLAG_DBCKEND | SDIO_FLAG_STBITERR)))
  {
    if (SDIO_GetFlagStatus(SDIO_FLAG_RXDAVL) != RESET)
    {
      *(tempscr + index) = SDIO_ReadData();
      index++;
    }
  }

  if (SDIO_GetFlagStatus(SDIO_FLAG_DTIMEOUT) != RESET)
  {
    SDIO_ClearFlag(SDIO_FLAG_DTIMEOUT);
    errorstatus = SD_DATA_TIMEOUT;
    return(errorstatus);
  }
  else if (SDIO_GetFlagStatus(SDIO_FLAG_DCRCFAIL) != RESET)
  {
    SDIO_ClearFlag(SDIO_FLAG_DCRCFAIL);
    errorstatus = SD_DATA_CRC_FAIL;
    return(errorstatus);
  }
  else if (SDIO_GetFlagStatus(SDIO_FLAG_RXOVERR) != RESET)
  {
    SDIO_ClearFlag(SDIO_FLAG_RXOVERR);
    errorstatus = SD_RX_OVERRUN;
    return(errorstatus);
  }
  else if (SDIO_GetFlagStatus(SDIO_FLAG_STBITERR) != RESET)
  {
    SDIO_ClearFlag(SDIO_FLAG_STBITERR);
    errorstatus = SD_START_BIT_ERR;
    return(errorstatus);
  }

  /*!< Clear all the static flags */
  SDIO_ClearFlag(SDIO_STATIC_FLAGS);

  *(pscr + 1) = ((tempscr[0] & SD_0TO7BITS) << 24) | ((tempscr[0] & SD_8TO15BITS) << 8) | ((tempscr[0] & SD_16TO23BITS) >> 8) | ((tempscr[0] & SD_24TO31BITS) >> 24);

  *(pscr) = ((tempscr[1] & SD_0TO7BITS) << 24) | ((tempscr[1] & SD_8TO15BITS) << 8) | ((tempscr[1] & SD_16TO23BITS) >> 8) | ((tempscr[1] & SD_24TO31BITS) >> 24);

  return(errorstatus);
}

//--------------------------------------------------------------
uint8_t convert_from_bytes_to_power_of_two(uint16_t NumberOfBytes)
{
  uint8_t count = 0;

  while (NumberOfBytes != 1)
  {
    NumberOfBytes >>= 1;
    count++;
  }
  return(count);
}

//--------------------------------------------------------------
SD_Error SD_HighSpeed (void)
{
  SD_Error errorstatus = SD_OK;
  uint32_t scr[2] = {0, 0};
  uint32_t SD_SPEC = 0 ;
  uint8_t hs[64] = {0} ;
  uint32_t  count = 0, *tempbuff = (uint32_t *)hs;
  TransferError = SD_OK;
  TransferEnd = 0;
  StopCondition = 0;

  SDIO->DCTRL = 0x0;

  /*!< Get SCR Register */
  errorstatus = FindSCR(RCA, scr);

  if (errorstatus != SD_OK)
  {
    return(errorstatus);
  }

  /* Test the Version supported by the card*/ 
  SD_SPEC = (scr[1]  & 0x01000000)||(scr[1]  & 0x02000000);

  if (SD_SPEC != SD_ALLZERO)
  {
    /* Set Block Size for Card */
    SDIO_CmdInitStructure.SDIO_Argument = (uint32_t)64;
    SDIO_CmdInitStructure.SDIO_CmdIndex = SD_CMD_SET_BLOCKLEN;
    SDIO_CmdInitStructure.SDIO_Response = SDIO_Response_Short;
    SDIO_CmdInitStructure.SDIO_Wait = SDIO_Wait_No;
    SDIO_CmdInitStructure.SDIO_CPSM = SDIO_CPSM_Enable;
    SDIO_SendCommand(&SDIO_CmdInitStructure);
    errorstatus = CmdResp1Error(SD_CMD_SET_BLOCKLEN);
    if (errorstatus != SD_OK)
    {
      return(errorstatus);
    }
    SDIO_DataInitStructure.SDIO_DataTimeOut = SD_DATATIMEOUT;
    SDIO_DataInitStructure.SDIO_DataLength = 64;
    SDIO_DataInitStructure.SDIO_DataBlockSize = SDIO_DataBlockSize_64b ;
    SDIO_DataInitStructure.SDIO_TransferDir = SDIO_TransferDir_ToSDIO;
    SDIO_DataInitStructure.SDIO_TransferMode = SDIO_TransferMode_Block;
    SDIO_DataInitStructure.SDIO_DPSM = SDIO_DPSM_Enable;
    SDIO_DataConfig(&SDIO_DataInitStructure);

    /*!< Send CMD6 switch mode */
    SDIO_CmdInitStructure.SDIO_Argument = 0x80FFFF01;
    SDIO_CmdInitStructure.SDIO_CmdIndex = SD_CMD_HS_SWITCH;
    SDIO_CmdInitStructure.SDIO_Response = SDIO_Response_Short;
    SDIO_CmdInitStructure.SDIO_Wait = SDIO_Wait_No;
    SDIO_CmdInitStructure.SDIO_CPSM = SDIO_CPSM_Enable;
    SDIO_SendCommand(&SDIO_CmdInitStructure); 
    errorstatus = CmdResp1Error(SD_CMD_HS_SWITCH);

    if (errorstatus != SD_OK)
    {
      return(errorstatus);
    }
    while (!(SDIO->STA &(SDIO_FLAG_RXOVERR | SDIO_FLAG_DCRCFAIL | SDIO_FLAG_DTIMEOUT | SDIO_FLAG_DBCKEND | SDIO_FLAG_STBITERR)))
    {
      if (SDIO_GetFlagStatus(SDIO_FLAG_RXFIFOHF) != RESET)
      {
        for (count = 0; count < 8; count++)
        {
          *(tempbuff + count) = SDIO_ReadData();
        }
        tempbuff += 8;
      }
    }
    
    if (SDIO_GetFlagStatus(SDIO_FLAG_DTIMEOUT) != RESET)
    {
      SDIO_ClearFlag(SDIO_FLAG_DTIMEOUT);
      errorstatus = SD_DATA_TIMEOUT;
      return(errorstatus);
    }
    else if (SDIO_GetFlagStatus(SDIO_FLAG_DCRCFAIL) != RESET)
    {
      SDIO_ClearFlag(SDIO_FLAG_DCRCFAIL);
      errorstatus = SD_DATA_CRC_FAIL;
      return(errorstatus);
    }
    else if (SDIO_GetFlagStatus(SDIO_FLAG_RXOVERR) != RESET)
    {
      SDIO_ClearFlag(SDIO_FLAG_RXOVERR);
      errorstatus = SD_RX_OVERRUN;
      return(errorstatus);
    }
    else if (SDIO_GetFlagStatus(SDIO_FLAG_STBITERR) != RESET)
    {
      SDIO_ClearFlag(SDIO_FLAG_STBITERR);
      errorstatus = SD_START_BIT_ERR;
      return(errorstatus);
    }
    count = SD_DATATIMEOUT;
    while ((SDIO_GetFlagStatus(SDIO_FLAG_RXDAVL) != RESET) && (count > 0))
    {
      *tempbuff = SDIO_ReadData();
      tempbuff++;
      count--;
    }

    /*!< Clear all the static flags */
    SDIO_ClearFlag(SDIO_STATIC_FLAGS);

    /* Test if the switch mode HS is ok */
    if ((hs[13]& 0x2)==0x2)
    {
      errorstatus=SD_OK;
    }
    else
    {
      errorstatus=SD_UNSUPPORTED_FEATURE ;
    }  
  }
  return(errorstatus);
}



//--------------------------------------------------------------
// Funktionen vom File :
// stm324xg_eval.c
// V1.1.1
// 11-January-2013
//--------------------------------------------------------------


//--------------------------------------------------------------
void SD_LowLevel_DeInit(void)
{
  GPIO_InitTypeDef  GPIO_InitStructure;
  
  /*!< Disable SDIO Clock */
  SDIO_ClockCmd(DISABLE);
  
  /*!< Set Power State to OFF */
  SDIO_SetPowerState(SDIO_PowerState_OFF);

  /*!< DeInitializes the SDIO peripheral */
  SDIO_DeInit();
  
  /* Disable the SDIO APB2 Clock */
  RCC_APB2PeriphClockCmd(RCC_APB2Periph_SDIO, DISABLE);

#if USE_SDIO_4BIT_MODE==1
  GPIO_PinAFConfig(GPIOC, GPIO_PinSource8, GPIO_AF_MCO);
  GPIO_PinAFConfig(GPIOC, GPIO_PinSource9, GPIO_AF_MCO);
  GPIO_PinAFConfig(GPIOC, GPIO_PinSource10, GPIO_AF_MCO);
  GPIO_PinAFConfig(GPIOC, GPIO_PinSource11, GPIO_AF_MCO);
  GPIO_PinAFConfig(GPIOC, GPIO_PinSource12, GPIO_AF_MCO);
  GPIO_PinAFConfig(GPIOD, GPIO_PinSource2, GPIO_AF_MCO);

  /* Configure PC.08, PC.09, PC.10, PC.11 pins: D0, D1, D2, D3 pins */
  GPIO_InitStructure.GPIO_Pin = GPIO_Pin_8 | GPIO_Pin_9 | GPIO_Pin_10 | GPIO_Pin_11;
  GPIO_InitStructure.GPIO_Mode = GPIO_Mode_IN;
  GPIO_InitStructure.GPIO_PuPd = GPIO_PuPd_NOPULL;
  GPIO_Init(GPIOC, &GPIO_InitStructure);
#else
  GPIO_PinAFConfig(GPIOC, GPIO_PinSource8, GPIO_AF_MCO);
  GPIO_PinAFConfig(GPIOC, GPIO_PinSource12, GPIO_AF_MCO);
  GPIO_PinAFConfig(GPIOD, GPIO_PinSource2, GPIO_AF_MCO);

  /* Configure PC.08 pins: D0 pins */
  GPIO_InitStructure.GPIO_Pin = GPIO_Pin_8;
  GPIO_InitStructure.GPIO_Mode = GPIO_Mode_IN;
  GPIO_InitStructure.GPIO_PuPd = GPIO_PuPd_NOPULL;
  GPIO_Init(GPIOC, &GPIO_InitStructure);
#endif

  /* Configure PD.02 CMD line */
  GPIO_InitStructure.GPIO_Pin = GPIO_Pin_2;
  GPIO_Init(GPIOD, &GPIO_InitStructure);

  /* Configure PC.12 pin: CLK pin */
  GPIO_InitStructure.GPIO_Pin = GPIO_Pin_12;
  GPIO_Init(GPIOC, &GPIO_InitStructure);
}

//--------------------------------------------------------------
void SD_LowLevel_Init(void)
{
  GPIO_InitTypeDef  GPIO_InitStructure;

#if USE_DETECT_PIN==1
  /* GPIOC and GPIOD Periph clock enable */
  RCC_AHB1PeriphClockCmd(RCC_AHB1Periph_GPIOC | RCC_AHB1Periph_GPIOD | SD_DETECT_GPIO_CLK, ENABLE);
#else
  /* GPIOC and GPIOD Periph clock enable */
  RCC_AHB1PeriphClockCmd(RCC_AHB1Periph_GPIOC | RCC_AHB1Periph_GPIOD, ENABLE);
#endif

#if USE_SDIO_4BIT_MODE==1
  GPIO_PinAFConfig(GPIOC, GPIO_PinSource8, GPIO_AF_SDIO);
  GPIO_PinAFConfig(GPIOC, GPIO_PinSource9, GPIO_AF_SDIO);
  GPIO_PinAFConfig(GPIOC, GPIO_PinSource10, GPIO_AF_SDIO);
  GPIO_PinAFConfig(GPIOC, GPIO_PinSource11, GPIO_AF_SDIO);
  GPIO_PinAFConfig(GPIOC, GPIO_PinSource12, GPIO_AF_SDIO);
  GPIO_PinAFConfig(GPIOD, GPIO_PinSource2, GPIO_AF_SDIO);

  /* Configure PC.08, PC.09, PC.10, PC.11 pins: D0, D1, D2, D3 pins */
  GPIO_InitStructure.GPIO_Pin = GPIO_Pin_8 | GPIO_Pin_9 | GPIO_Pin_10 | GPIO_Pin_11;
  GPIO_InitStructure.GPIO_Speed = GPIO_Speed_50MHz;
  GPIO_InitStructure.GPIO_Mode = GPIO_Mode_AF;
  GPIO_InitStructure.GPIO_OType = GPIO_OType_PP;
  GPIO_InitStructure.GPIO_PuPd = GPIO_PuPd_UP;
  GPIO_Init(GPIOC, &GPIO_InitStructure);
#else
  GPIO_PinAFConfig(GPIOC, GPIO_PinSource8, GPIO_AF_SDIO);
  GPIO_PinAFConfig(GPIOC, GPIO_PinSource12, GPIO_AF_SDIO);
  GPIO_PinAFConfig(GPIOD, GPIO_PinSource2, GPIO_AF_SDIO);

  /* Configure PC.08 pins: D0 pins */
  GPIO_InitStructure.GPIO_Pin = GPIO_Pin_8;
  GPIO_InitStructure.GPIO_Speed = GPIO_Speed_50MHz;
  GPIO_InitStructure.GPIO_Mode = GPIO_Mode_AF;
  GPIO_InitStructure.GPIO_OType = GPIO_OType_PP;
  GPIO_InitStructure.GPIO_PuPd = GPIO_PuPd_UP;
  GPIO_Init(GPIOC, &GPIO_InitStructure);
#endif

  /* Configure PD.02 CMD line */
  GPIO_InitStructure.GPIO_Pin = GPIO_Pin_2;
  GPIO_Init(GPIOD, &GPIO_InitStructure);

  /* Configure PC.12 pin: CLK pin */
  GPIO_InitStructure.GPIO_Pin = GPIO_Pin_12;
  GPIO_InitStructure.GPIO_PuPd = GPIO_PuPd_NOPULL;
  GPIO_Init(GPIOC, &GPIO_InitStructure);
  
#if USE_DETECT_PIN==1
  /*!< Configure SD_SPI_DETECT_PIN pin: SD Card detect pin */
  GPIO_InitStructure.GPIO_Pin = SD_DETECT_PIN;
  GPIO_InitStructure.GPIO_Mode = GPIO_Mode_IN;
  GPIO_InitStructure.GPIO_PuPd = GPIO_PuPd_UP;
  GPIO_Init(SD_DETECT_GPIO_PORT, &GPIO_InitStructure);
#endif

  /* Enable the SDIO APB2 Clock */
  RCC_APB2PeriphClockCmd(RCC_APB2Periph_SDIO, ENABLE);

  /* Enable the DMA2 Clock */
  RCC_AHB1PeriphClockCmd(SD_SDIO_DMA_CLK, ENABLE);
}

//--------------------------------------------------------------
void SD_LowLevel_DMA_TxConfig(uint32_t *BufferSRC, uint32_t BufferSize)
{
  DMA_InitTypeDef SDDMA_InitStructure;

  DMA_ClearFlag(SD_SDIO_DMA_STREAM, SD_SDIO_DMA_FLAG_FEIF | SD_SDIO_DMA_FLAG_DMEIF | SD_SDIO_DMA_FLAG_TEIF | SD_SDIO_DMA_FLAG_HTIF | SD_SDIO_DMA_FLAG_TCIF);

  /* DMA2 Stream3  or Stream6 disable */
  DMA_Cmd(SD_SDIO_DMA_STREAM, DISABLE);

  /* DMA2 Stream3  or Stream6 Config */
  DMA_DeInit(SD_SDIO_DMA_STREAM);

  SDDMA_InitStructure.DMA_Channel = SD_SDIO_DMA_CHANNEL;
  SDDMA_InitStructure.DMA_PeripheralBaseAddr = (uint32_t)SDIO_FIFO_ADDRESS;
  SDDMA_InitStructure.DMA_Memory0BaseAddr = (uint32_t)BufferSRC;
  SDDMA_InitStructure.DMA_DIR = DMA_DIR_MemoryToPeripheral;
  SDDMA_InitStructure.DMA_BufferSize = BufferSize;
  SDDMA_InitStructure.DMA_PeripheralInc = DMA_PeripheralInc_Disable;
  SDDMA_InitStructure.DMA_MemoryInc = DMA_MemoryInc_Enable;
  SDDMA_InitStructure.DMA_PeripheralDataSize = DMA_PeripheralDataSize_Word;
  SDDMA_InitStructure.DMA_MemoryDataSize = DMA_MemoryDataSize_Word;
  SDDMA_InitStructure.DMA_Mode = DMA_Mode_Normal;
  SDDMA_InitStructure.DMA_Priority = DMA_Priority_VeryHigh;
  SDDMA_InitStructure.DMA_FIFOMode = DMA_FIFOMode_Enable;
  SDDMA_InitStructure.DMA_FIFOThreshold = DMA_FIFOThreshold_Full;
  SDDMA_InitStructure.DMA_MemoryBurst = DMA_MemoryBurst_INC4;
  SDDMA_InitStructure.DMA_PeripheralBurst = DMA_PeripheralBurst_INC4;
  DMA_Init(SD_SDIO_DMA_STREAM, &SDDMA_InitStructure);
  DMA_ITConfig(SD_SDIO_DMA_STREAM, DMA_IT_TC, ENABLE);
  DMA_FlowControllerConfig(SD_SDIO_DMA_STREAM, DMA_FlowCtrl_Peripheral);

  /* DMA2 Stream3  or Stream6 enable */
  DMA_Cmd(SD_SDIO_DMA_STREAM, ENABLE);
    
}

//--------------------------------------------------------------
void SD_LowLevel_DMA_RxConfig(uint32_t *BufferDST, uint32_t BufferSize)
{
  DMA_InitTypeDef SDDMA_InitStructure;

  DMA_ClearFlag(SD_SDIO_DMA_STREAM, SD_SDIO_DMA_FLAG_FEIF | SD_SDIO_DMA_FLAG_DMEIF | SD_SDIO_DMA_FLAG_TEIF | SD_SDIO_DMA_FLAG_HTIF | SD_SDIO_DMA_FLAG_TCIF);

  /* DMA2 Stream3  or Stream6 disable */
  DMA_Cmd(SD_SDIO_DMA_STREAM, DISABLE);

  /* DMA2 Stream3 or Stream6 Config */
  DMA_DeInit(SD_SDIO_DMA_STREAM);

  SDDMA_InitStructure.DMA_Channel = SD_SDIO_DMA_CHANNEL;
  SDDMA_InitStructure.DMA_PeripheralBaseAddr = (uint32_t)SDIO_FIFO_ADDRESS;
  SDDMA_InitStructure.DMA_Memory0BaseAddr = (uint32_t)BufferDST;
  SDDMA_InitStructure.DMA_DIR = DMA_DIR_PeripheralToMemory;
  SDDMA_InitStructure.DMA_BufferSize = BufferSize;
  SDDMA_InitStructure.DMA_PeripheralInc = DMA_PeripheralInc_Disable;
  SDDMA_InitStructure.DMA_MemoryInc = DMA_MemoryInc_Enable;
  SDDMA_InitStructure.DMA_PeripheralDataSize = DMA_PeripheralDataSize_Word;
  SDDMA_InitStructure.DMA_MemoryDataSize = DMA_MemoryDataSize_Word;
  SDDMA_InitStructure.DMA_Mode = DMA_Mode_Normal;
  SDDMA_InitStructure.DMA_Priority = DMA_Priority_VeryHigh;
  SDDMA_InitStructure.DMA_FIFOMode = DMA_FIFOMode_Enable;
  SDDMA_InitStructure.DMA_FIFOThreshold = DMA_FIFOThreshold_Full;
  SDDMA_InitStructure.DMA_MemoryBurst = DMA_MemoryBurst_INC4;
  SDDMA_InitStructure.DMA_PeripheralBurst = DMA_PeripheralBurst_INC4;
  DMA_Init(SD_SDIO_DMA_STREAM, &SDDMA_InitStructure);
  DMA_ITConfig(SD_SDIO_DMA_STREAM, DMA_IT_TC, ENABLE);
  DMA_FlowControllerConfig(SD_SDIO_DMA_STREAM, DMA_FlowCtrl_Peripheral);

  /* DMA2 Stream3 or Stream6 enable */
  DMA_Cmd(SD_SDIO_DMA_STREAM, ENABLE);
}

//--------------------------------------------------------------
// Interrupt-Funktionen
//--------------------------------------------------------------
void SDIO_IRQHandler(void)
{
  /* Process All SDIO Interrupt Sources */
  SD_ProcessIRQSrc();
}


void SD_SDIO_DMA_IRQHANDLER(void)
{
  /* Process DMA2 Stream3 or DMA2 Stream6 Interrupt Sources */
  SD_ProcessDMAIRQ();
}
