AugustoRiedinger/tecDig2_project/doc/proyectoCompleto_Riedinger-Garcia/erdytc/src/_menus.h

#ifndef _MENUS_H_
#define _MENUS_H_

#include "libs.h"

void INITIAL_SCREEN(void);
void UPDATE_TEMP(void);
void MOVE_SERVO_1(void);
void MOVE_SERVO_2(void);
void SD(void);
float DECODE_TEMP(char* tempChar);

#endif // _MENUS_H_
