AugustoRiedinger/tecDig2_project/doc/proyectoCompleto_Riedinger-Garcia/satdac/src/_libs.h

#ifndef _LIBS_H_
#define _LIBS_H_

/*Librerias estandar:*/
#include "standar.h"
/*Definicion pines del hardware:*/
#include "hardware.h"
/*Control de los pines USART:*/
#include "_usart.h"
/*Control pin ADC:*/
#include "_adc.h"
/*Control del servomotor:*/
#include "_servo.h"
/*Control de la tarjeta SD:*/
#include "_sd.h"
/*Control de timers:*/
#include "_timers.h"


#endif // _LIBS_H_
