AugustoRiedinger/tecDig2_project/(commit log)

2022-01-15 Finalizada descripción inicial del proyecto en el código STM
2022-01-15 Realizado el template para el código del SATDAC
2022-01-16 [C - S] Incluídas librerías a utilizar e inicialización general de estructuras
2022-01-17 [C-S] Creada función y constantes para controlar el servo y el TIM3
2022-01-17 [C-S] Finalizada función para inicializar el TIM4 como controlador de la frecuencia PWM
2022-01-17 [C-S] Finalizada función para inicializar las salidas PWM
2022-01-17 [C-S] Finalizada función para inicializar salida servo
2022-01-17 [C-S] Configurado clock y realizada inicialización de componentes para manejo del servo
2022-01-26 [C-E] Added switchs and LCD hardware definitions
2022-01-31 [C-E] Finished EXTI interruption subrutine
2022-02-01 [C-E] Finished TIM3/LCD interruption subrutine
2022-02-06 [C-S] Finished ADC configuration and subrutines - Finished USART subrutines
2022-02-15 [C] Finished servo logic
2022-02-15 [C] Initialized ADC control
2022-02-15 [C] Edited DMA configuration to work in continuos mode
2022-02-15 [C] Edited DMA interruption handler
2022-02-15 [C] Created SM for controlling the LCD and processing ADC data
2022-02-17 [C-S] Added DMA config with TIM2 TMRGO
2022-02-17 Created test case to try new USART hardware
2022-02-17 Tested USART transmission and servo motion patterns
2022-02-19 Added funtions to use the ADC without relaying in the DMA
2022-02-22 Created subrutine to code and decode temperature values
2022-02-22 Finished all docs/
    [cube V1.4( final).pdsprj, estacion v1.3.pdsprj]
